pyrat/sv/sv-docs/dawinchi/CCP-wire-diag-1.png

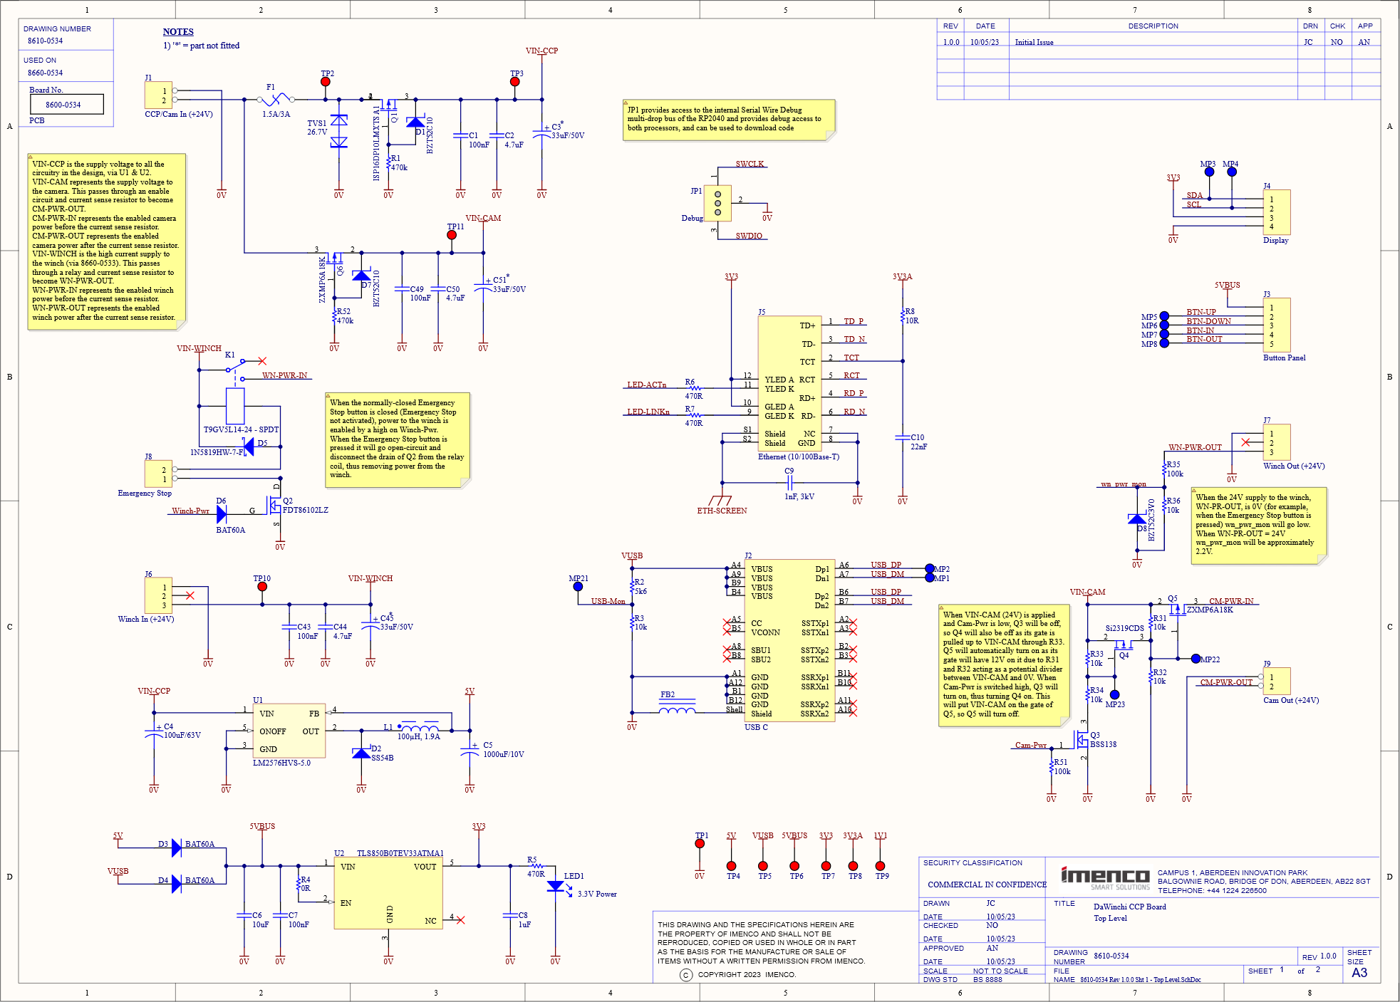
sv-docs/dawinchi/CCP-wire-diag-1.png
