pyrat/sv/sv-docs/dawinchi/CCP-wire-diag-2.png

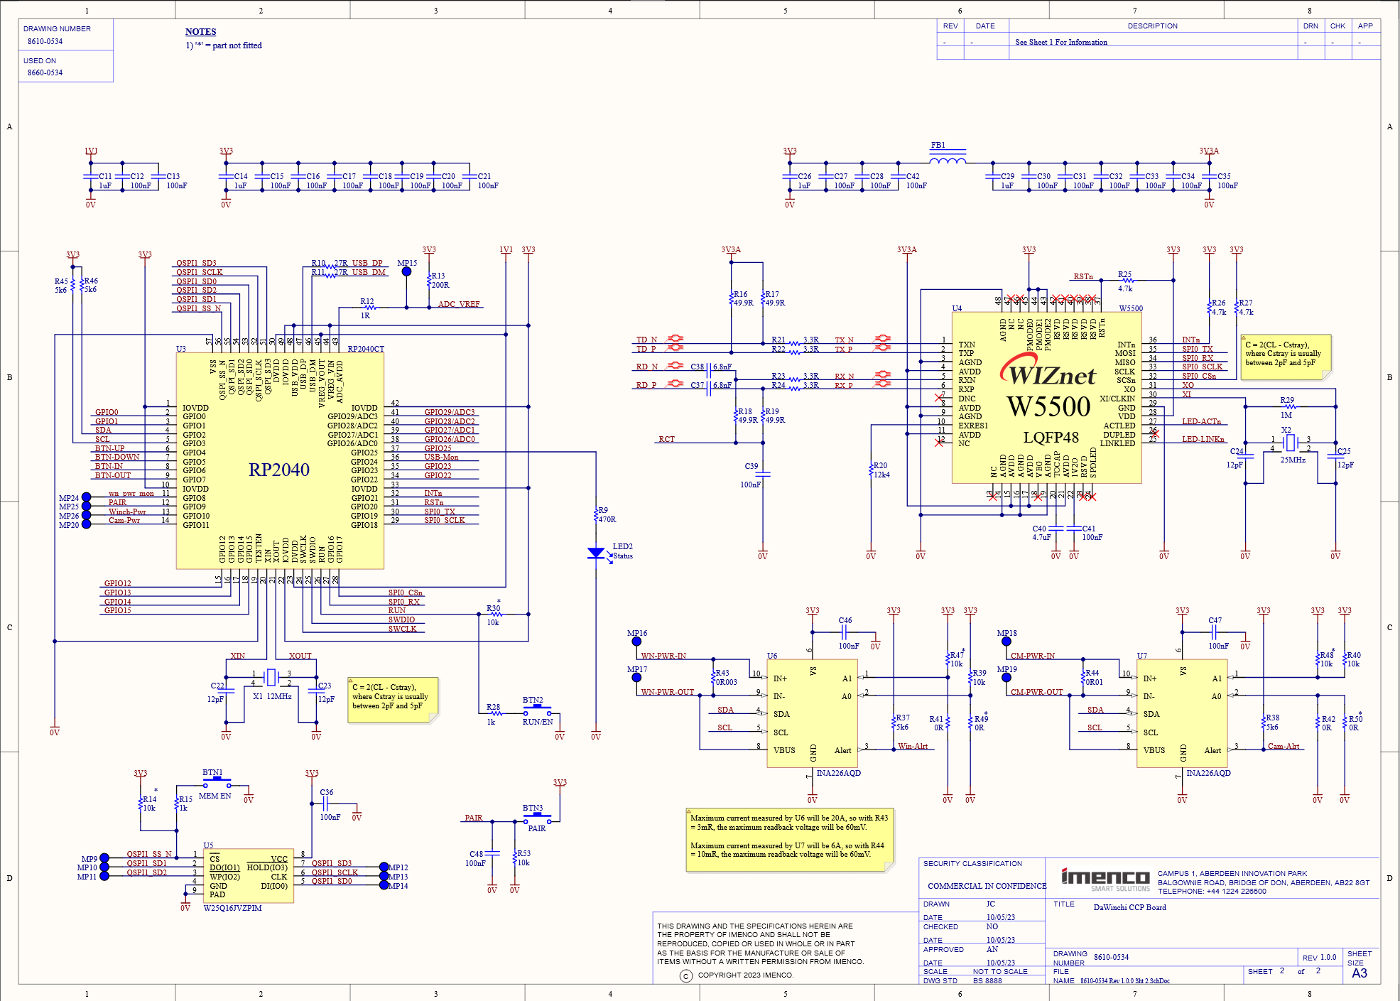
sv-docs/dawinchi/CCP-wire-diag-2.png
