pyrat/sv/sv-docs/dawinchi/dawinchi_ccp_oled_ui_design-hd.png

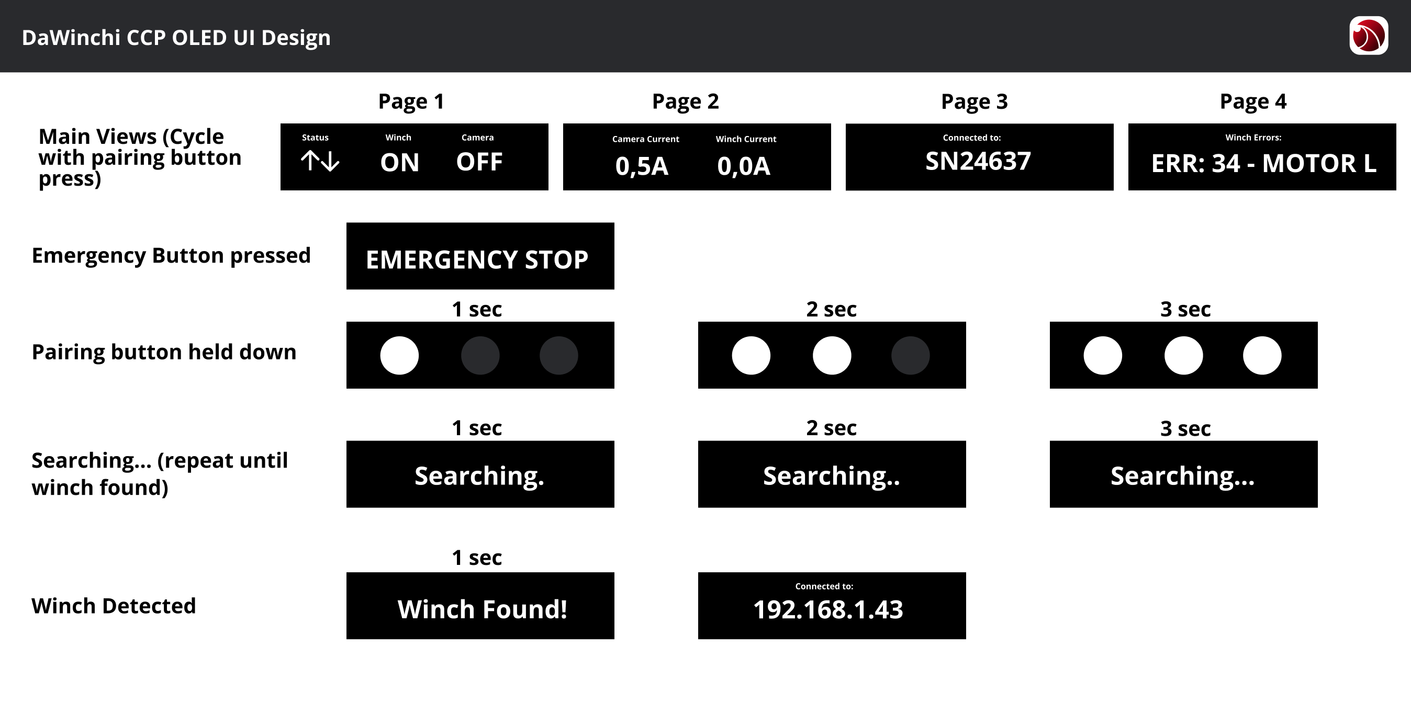
sv-docs/dawinchi/dawinchi_ccp_oled_ui_design-hd.png
