pyrat/sv/mechanical/prototype-enclosure/assembly-reference.stl

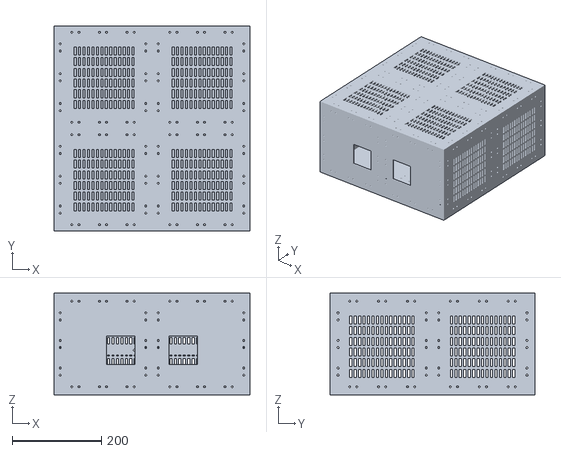
[picture p4: CAD file, 2026-10-30]
mechanical/prototype-enclosure/assembly-reference.stl
440.0 x 460.0 x 228.0
