pyrat/sv/mechanical/fit0737-din/fit0737-din-print-in-place.stl

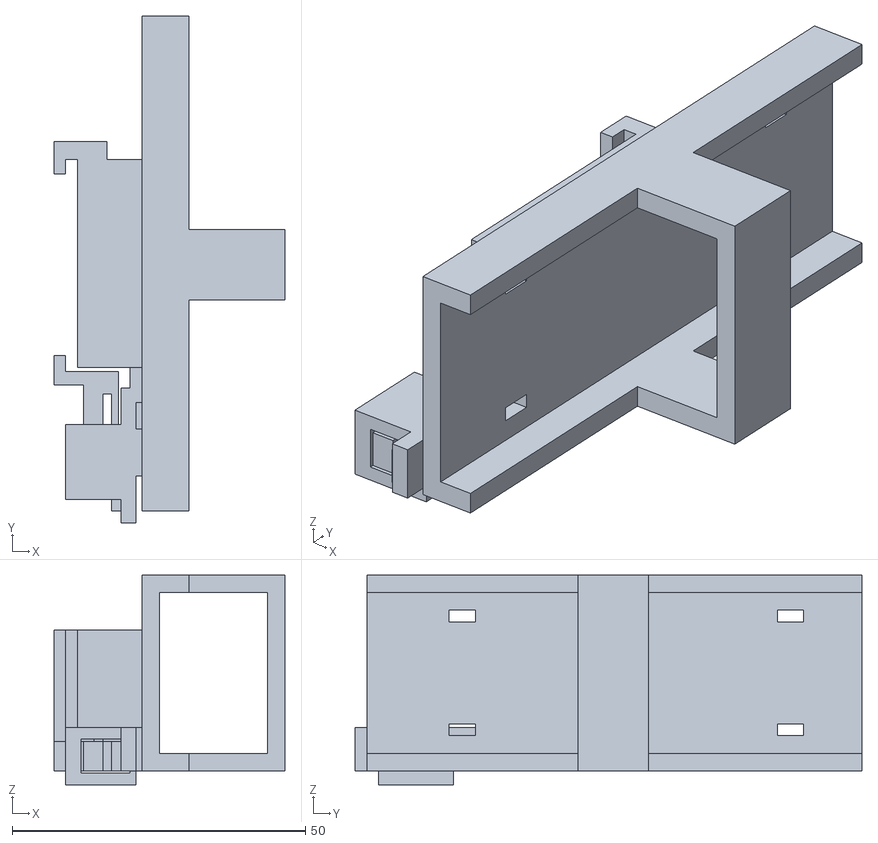
[picture p5: CAD file, 2026-11-07]
mechanical/fit0737-din/fit0737-din-print-in-place.stl
39.4 x 86.4 x 35.8
