pyrat/sv/mechanical/hinged-roof-v4/stl/shaft-blank.stl

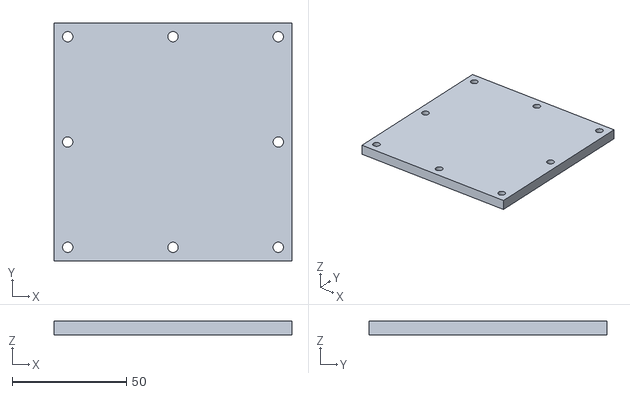
[picture p6: CAD file, 2026-10-30]
mechanical/hinged-roof-v4/stl/shaft-blank.stl
104.0 x 104.0 x 6.00
