pyrat/sv/mechanical/jetson-orin-din/jetson-orin-din-clip-test.stl

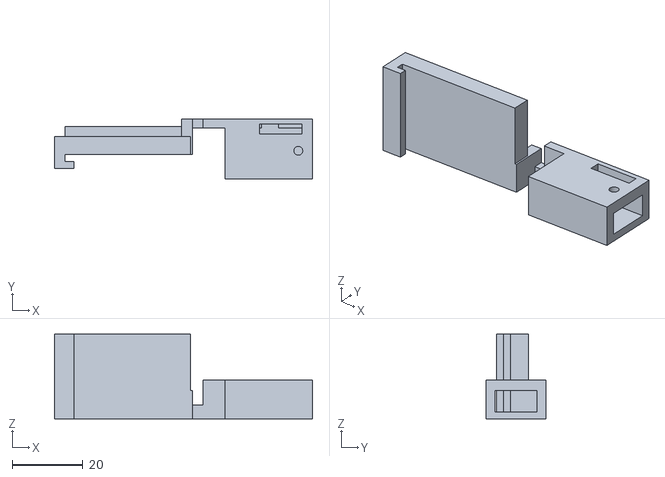
[picture p7: CAD file, 2026-11-07]
mechanical/jetson-orin-din/jetson-orin-din-clip-test.stl
73.0 x 17.0 x 24.0
