pyrat/sv/mechanical/outdoor-enclosure/stl/interface-gasket-tpu.stl

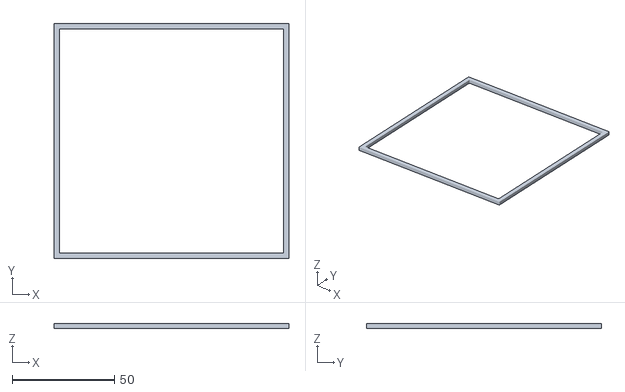
[picture p8: CAD file, 2026-10-30]
mechanical/outdoor-enclosure/stl/interface-gasket-tpu.stl
114.8 x 114.8 x 2.40
