pyrat/sv/mechanical/printed-drums/y-removable-flange.stl

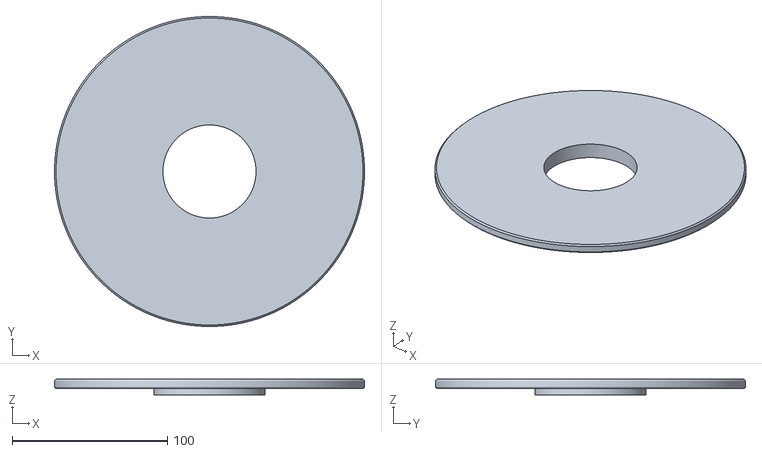
[picture p9: CAD file, 2026-10-15]
mechanical/printed-drums/y-removable-flange.stl
200.0 x 200.0 x 10.0
