pyrat/sv/mechanical/prototype-drums/drum-body.stl

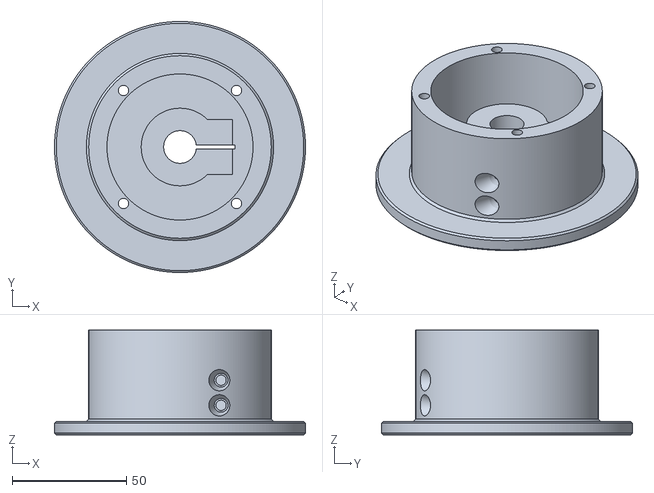
[picture p10: CAD file, 2026-10-28]
mechanical/prototype-drums/drum-body.stl
110.0 x 110.0 x 46.0
