pyrat/sv/mechanical/prototype-enclosure/stl/seam-splice.stl

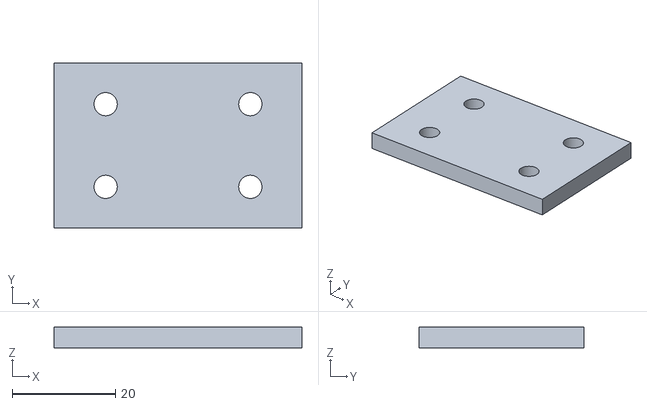
[picture p11: CAD file, 2026-10-30]
mechanical/prototype-enclosure/stl/seam-splice.stl
48.0 x 32.0 x 4.00
