pyrat/sv/mechanical/two-box-v3/stl/equipment-mounting-blank.stl

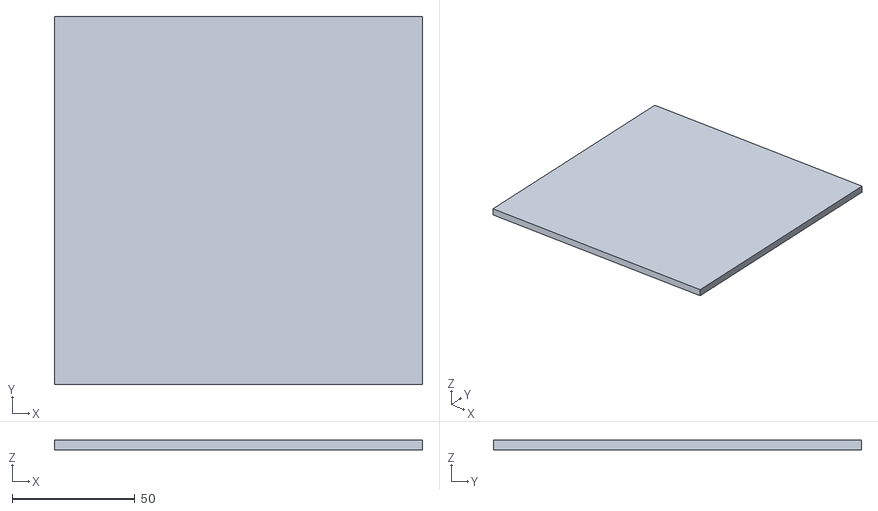
[picture p12: CAD file, 2026-10-30]
mechanical/two-box-v3/stl/equipment-mounting-blank.stl
150.0 x 150.0 x 4.00
