pyrat/sv/mechanical/hinged-roof-v4/stl/motor-base-fit-template.stl

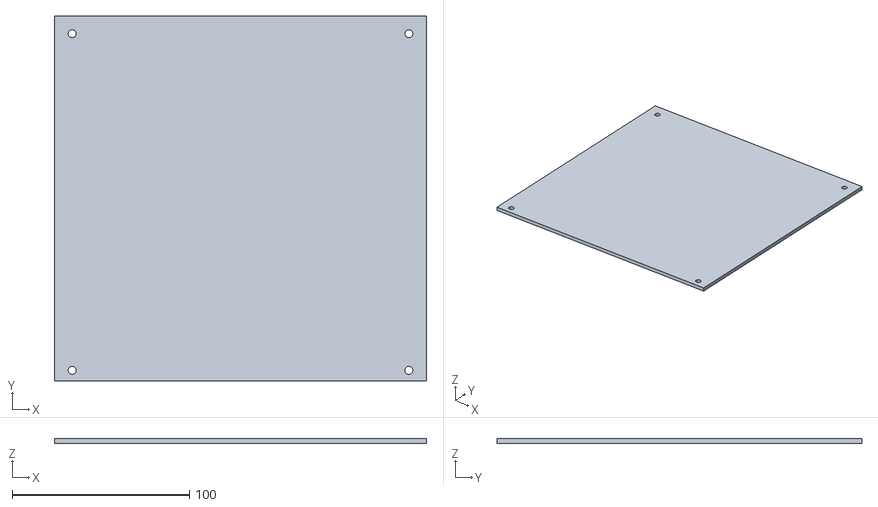
[picture p13: CAD file, 2026-10-30]
mechanical/hinged-roof-v4/stl/motor-base-fit-template.stl
210.0 x 206.0 x 3.00
