pyrat/sv/mechanical/jetson-orin-din/jetson-orin-din-slider.stl

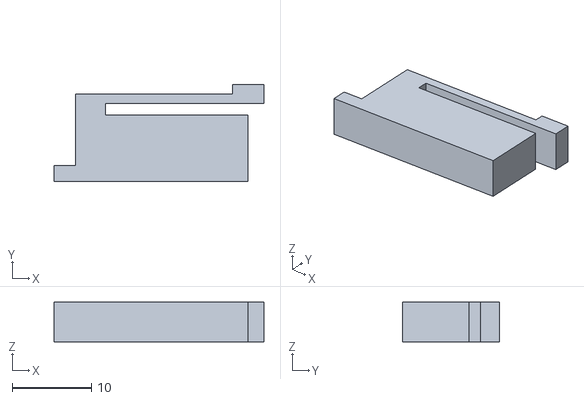
[picture p14: CAD file, 2026-11-07]
mechanical/jetson-orin-din/jetson-orin-din-slider.stl
26.5 x 12.2 x 5.00
