pyrat/sv/mechanical/outdoor-enclosure/stl/seal-test-base.stl

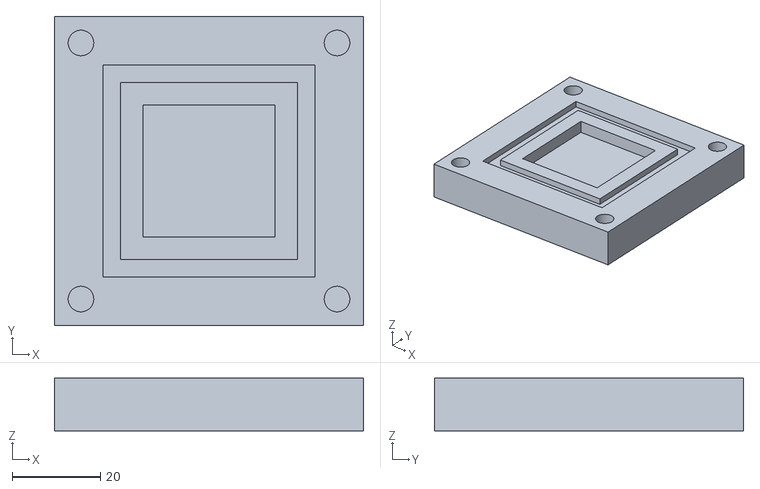
[picture p15: CAD file, 2026-10-30]
mechanical/outdoor-enclosure/stl/seal-test-base.stl
70.0 x 70.0 x 12.0
