pyrat/sv/mechanical/printed-drums/x-removable-flange.stl

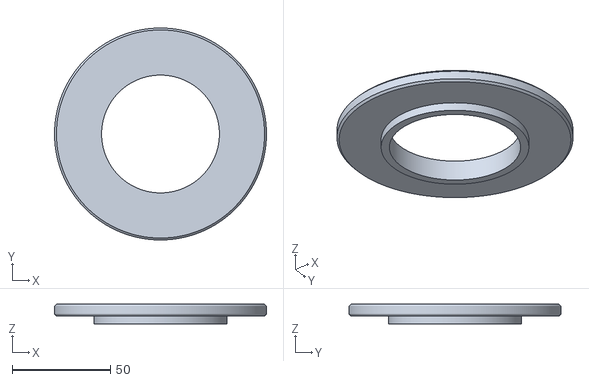
[picture p16: CAD file, 2026-10-15]
mechanical/printed-drums/x-removable-flange.stl
108.0 x 108.0 x 10.0
