pyrat/sv/mechanical/prototype-drums/drum-one-piece.stl

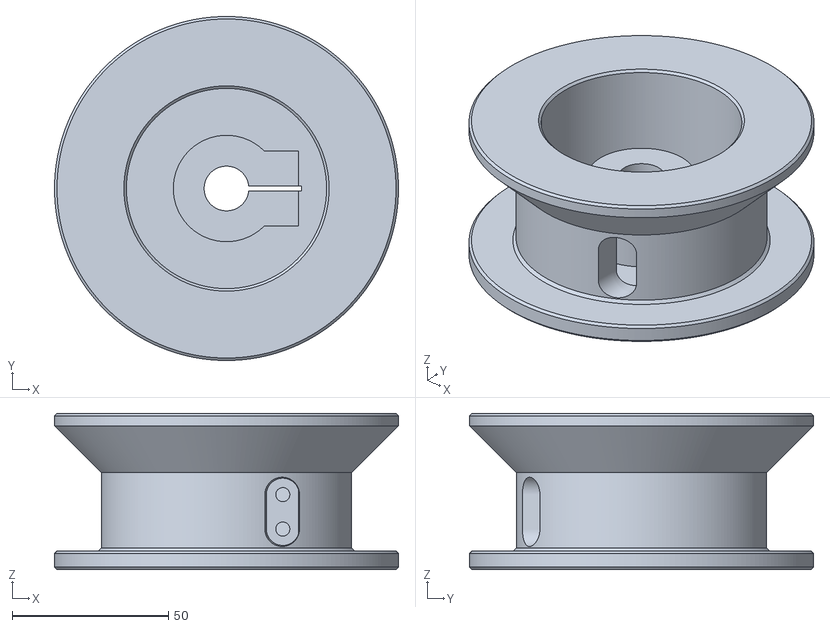
[picture p17: CAD file, 2026-10-28]
mechanical/prototype-drums/drum-one-piece.stl
110.0 x 110.0 x 50.0
