pyrat/sv/mechanical/prototype-enclosure/stl/rail-spacer.stl

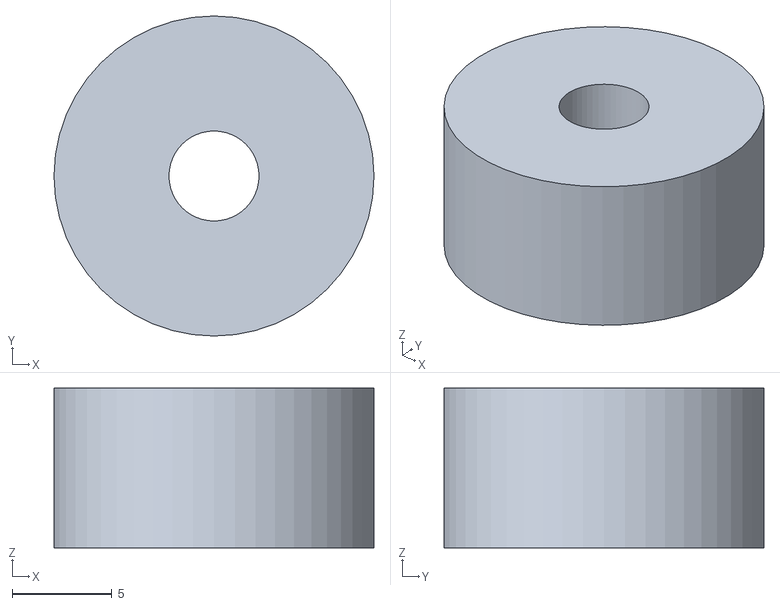
[picture p18: CAD file, 2026-10-30]
mechanical/prototype-enclosure/stl/rail-spacer.stl
16.0 x 16.0 x 8.00
