pyrat/sv/mechanical/two-box-v3/stl/winch-base.stl

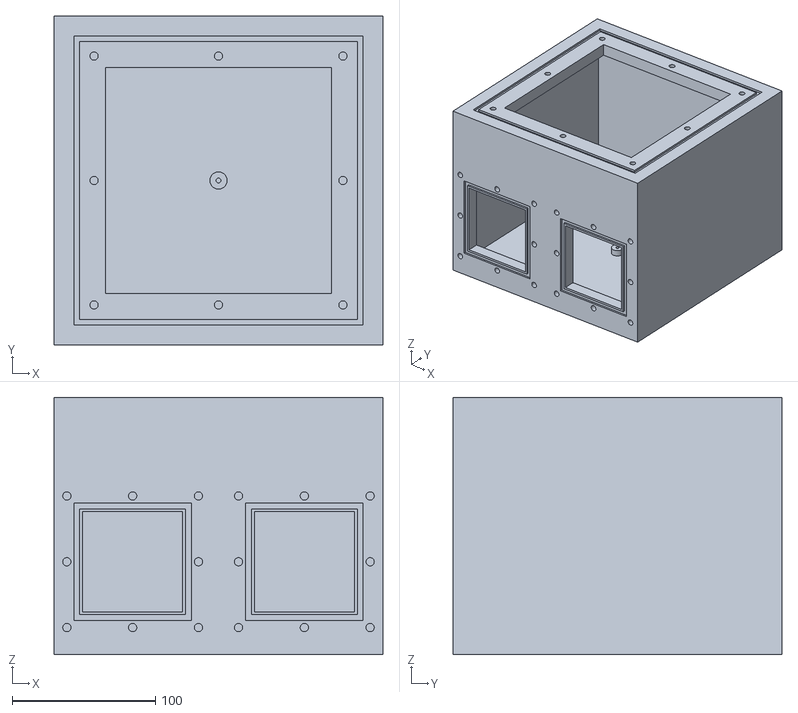
[picture p19: CAD file, 2026-10-30]
mechanical/two-box-v3/stl/winch-base.stl
230.0 x 230.0 x 180.0
