pyrat/sv/mechanical/hinged-roof-v4/stl/hinge-fixed-fit-template.stl

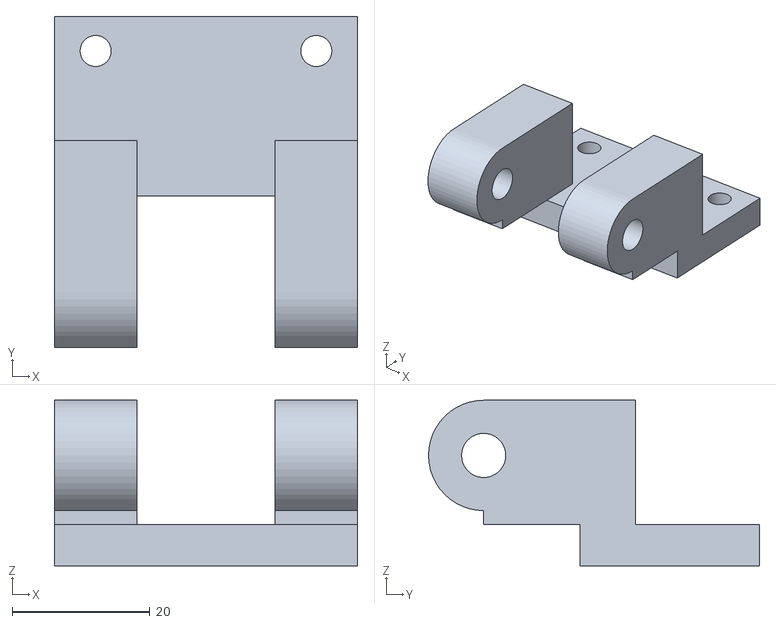
[picture p20: CAD file, 2026-10-30]
mechanical/hinged-roof-v4/stl/hinge-fixed-fit-template.stl
44.0 x 48.0 x 24.0
