pyrat/sv/mechanical/jetson-orin-din/jetson-orin-din-body.stl

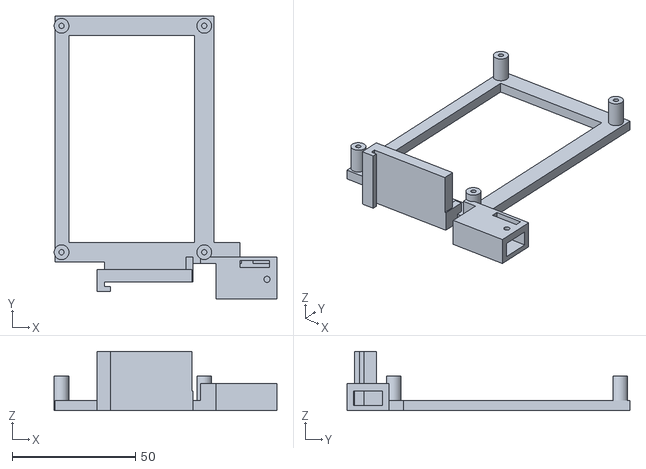
[picture p21: CAD file, 2026-11-07]
mechanical/jetson-orin-din/jetson-orin-din-body.stl
90.5 x 115.0 x 24.0
