pyrat/sv/mechanical/outdoor-enclosure/stl/cell-body.stl

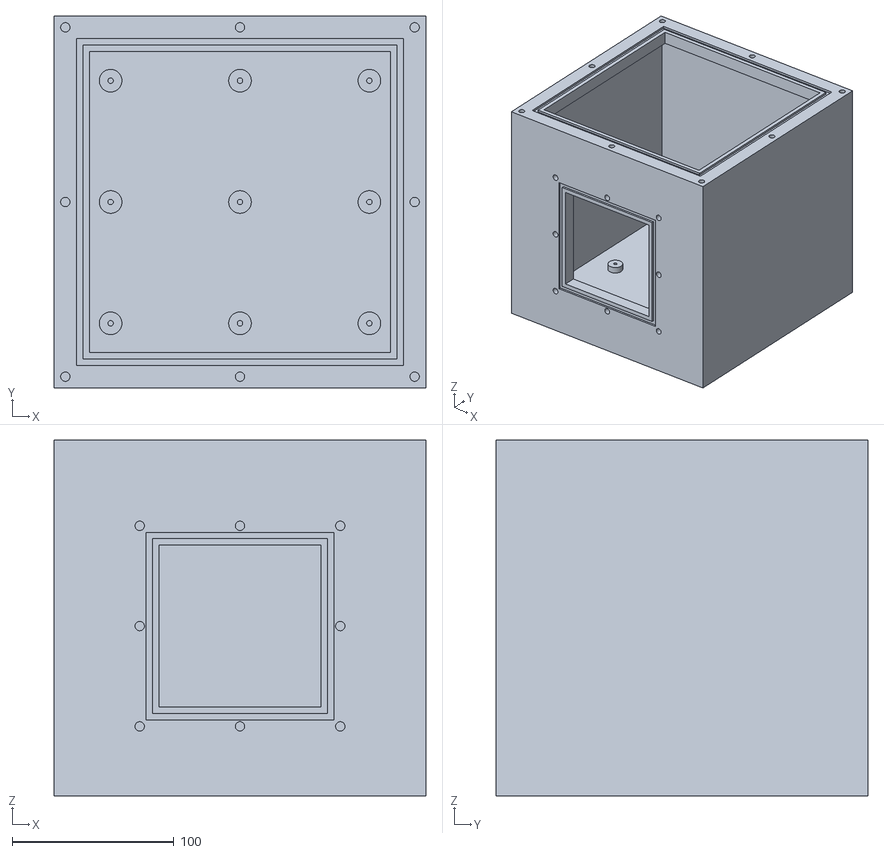
[picture p22: CAD file, 2026-10-30]
mechanical/outdoor-enclosure/stl/cell-body.stl
230.0 x 230.0 x 220.0
