pyrat/sv/mechanical/prototype-enclosure/stl/equipment-pad.stl

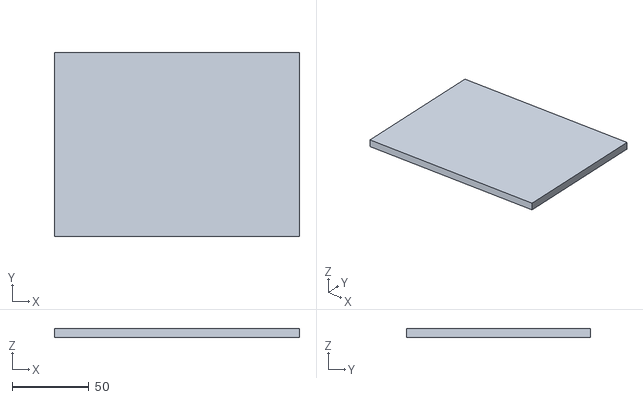
[picture p23: CAD file, 2026-10-30]
mechanical/prototype-enclosure/stl/equipment-pad.stl
160.0 x 120.0 x 6.00
