pyrat/sv/mechanical/two-box-v3/stl/winch-riser.stl

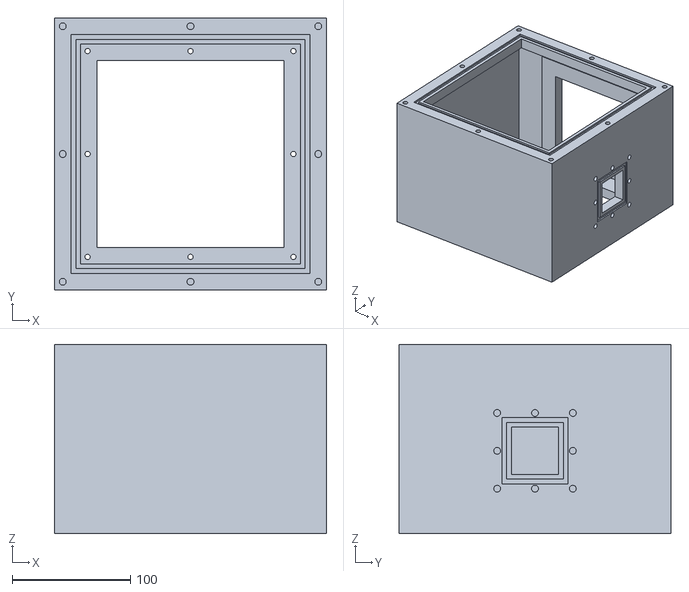
[picture p24: CAD file, 2026-10-30]
mechanical/two-box-v3/stl/winch-riser.stl
230.0 x 230.0 x 160.0
