pyrat/sv/mechanical/hinged-roof-v4/stl/driver-suspension-fit-template.stl

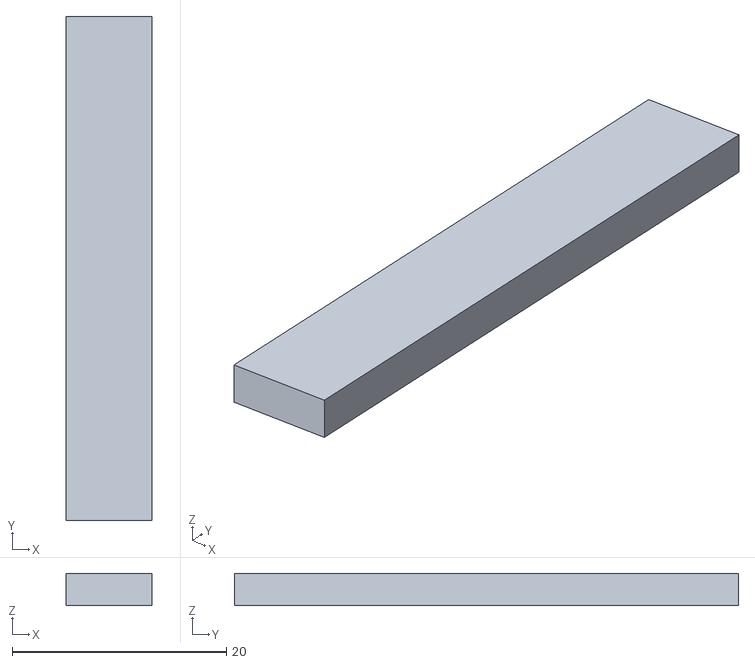
[picture p25: CAD file, 2026-10-30]
mechanical/hinged-roof-v4/stl/driver-suspension-fit-template.stl
8.00 x 47.0 x 3.00
