pyrat/sv/mechanical/jetson-orin-din/jetson-orin-din-print-in-place.stl

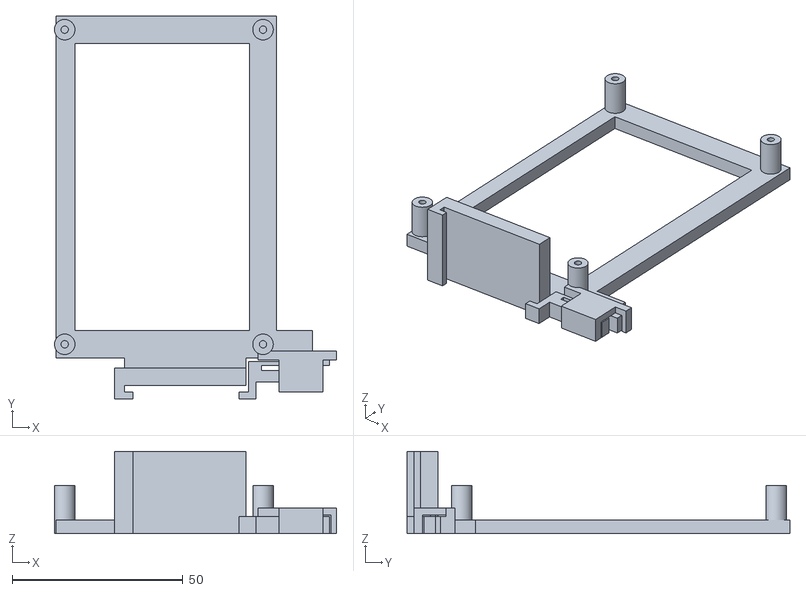
[picture p26: CAD file, 2026-11-04]
mechanical/jetson-orin-din/jetson-orin-din-print-in-place.stl
82.5 x 112.0 x 24.0
