pyrat/sv/mechanical/prototype-enclosure/stl/side-fan-tile.stl

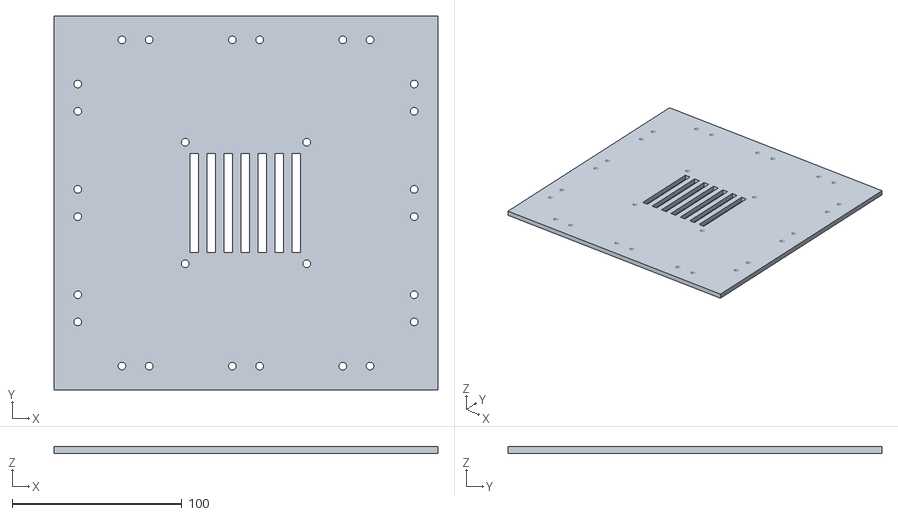
[picture p27: CAD file, 2026-10-30]
mechanical/prototype-enclosure/stl/side-fan-tile.stl
226.0 x 220.0 x 4.00
