pyrat/sv/mechanical/two-box-v3/stl/power-compute-riser.stl

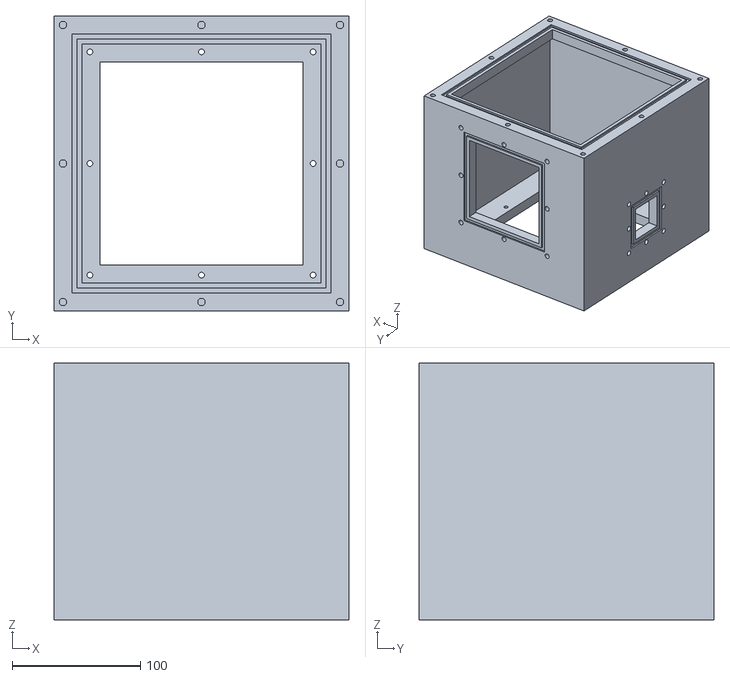
[picture p28: CAD file, 2026-10-30]
mechanical/two-box-v3/stl/power-compute-riser.stl
230.0 x 230.0 x 200.0
