pyrat/sv/mechanical/hinged-roof-v4/stl/din-suspension-fit-template.stl

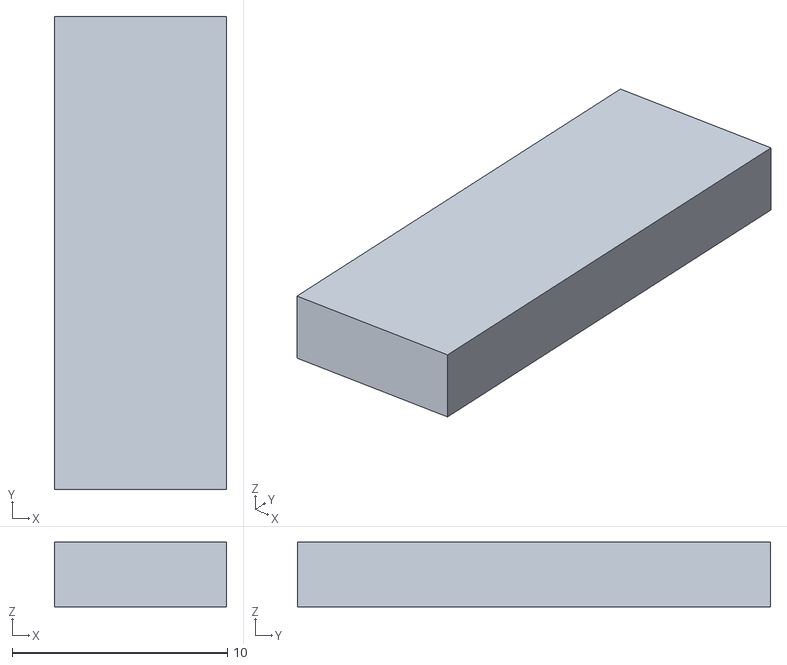
[picture p29: CAD file, 2026-10-30]
mechanical/hinged-roof-v4/stl/din-suspension-fit-template.stl
8.00 x 22.0 x 3.00
