pyrat/sv/mechanical/two-box-v3/stl/rain-skirt-lid.stl

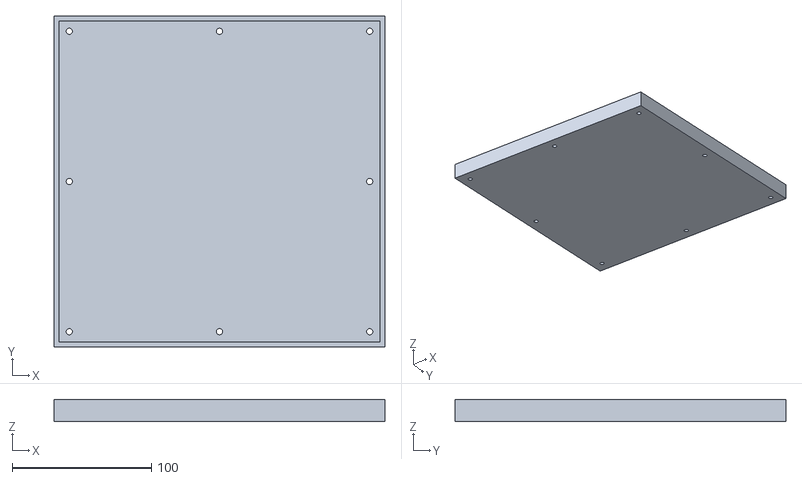
[picture p30: CAD file, 2026-10-30]
mechanical/two-box-v3/stl/rain-skirt-lid.stl
238.0 x 238.0 x 16.0
