pyrat/sv/mechanical/hinged-roof-v4/stl/hinged-hood.stl

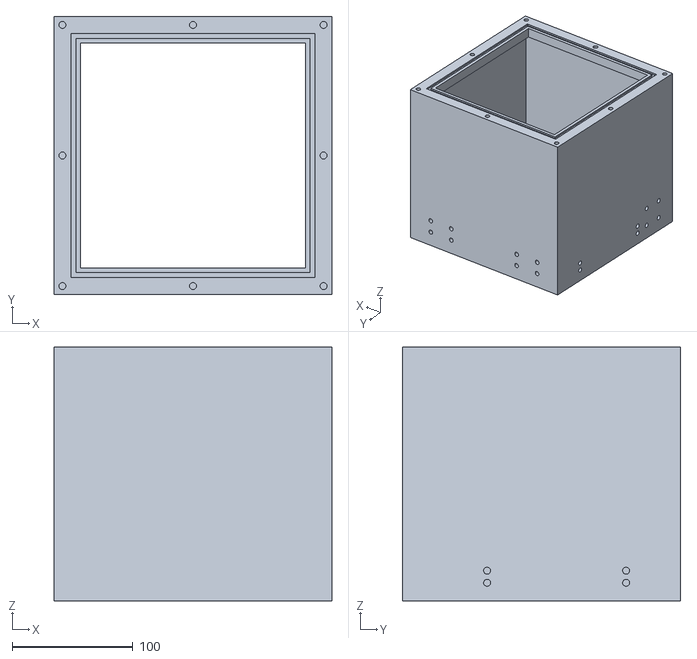
[picture p31: CAD file, 2026-10-30]
mechanical/hinged-roof-v4/stl/hinged-hood.stl
230.0 x 230.0 x 210.0
