pyrat/sv/mechanical/hinged-roof-v4/stl/closing-clamp-base-fit-template.stl

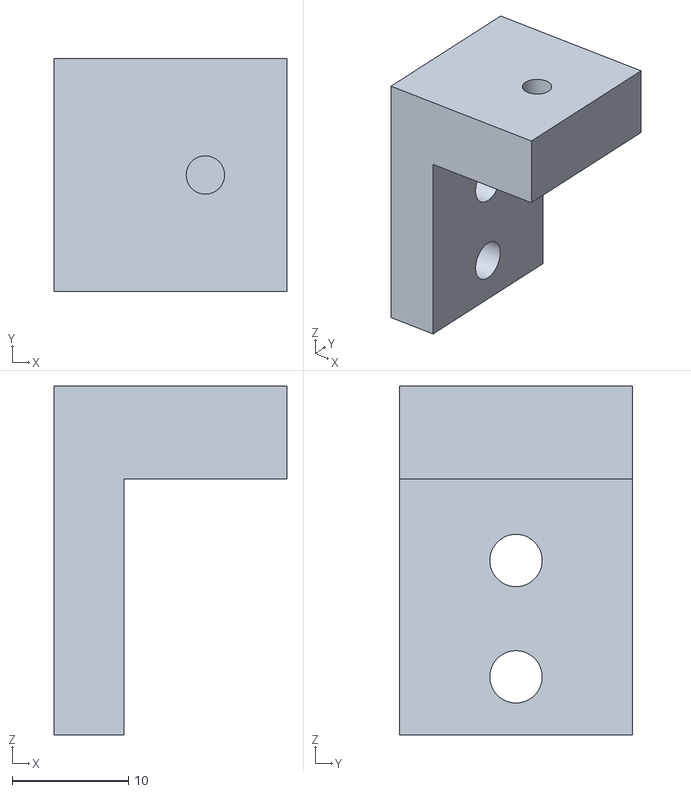
[picture p32: CAD file, 2026-10-30]
mechanical/hinged-roof-v4/stl/closing-clamp-base-fit-template.stl
20.0 x 20.0 x 30.0
