pyrat/sv/mechanical/hinged-roof-v4/stl/din-panel-fit-template.stl

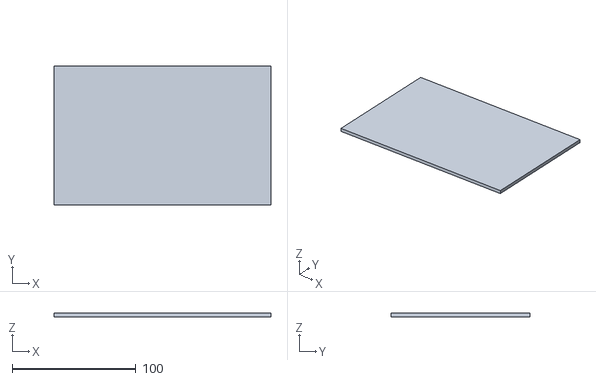
[picture p33: CAD file, 2026-10-30]
mechanical/hinged-roof-v4/stl/din-panel-fit-template.stl
175.0 x 112.0 x 3.00
