pyrat/sv/(list of files, cad)

Other CAD files:
mechanical/hinged-roof-v4/stl/roof.stl
