pyrat/sv/mechanical/ropesetup.png

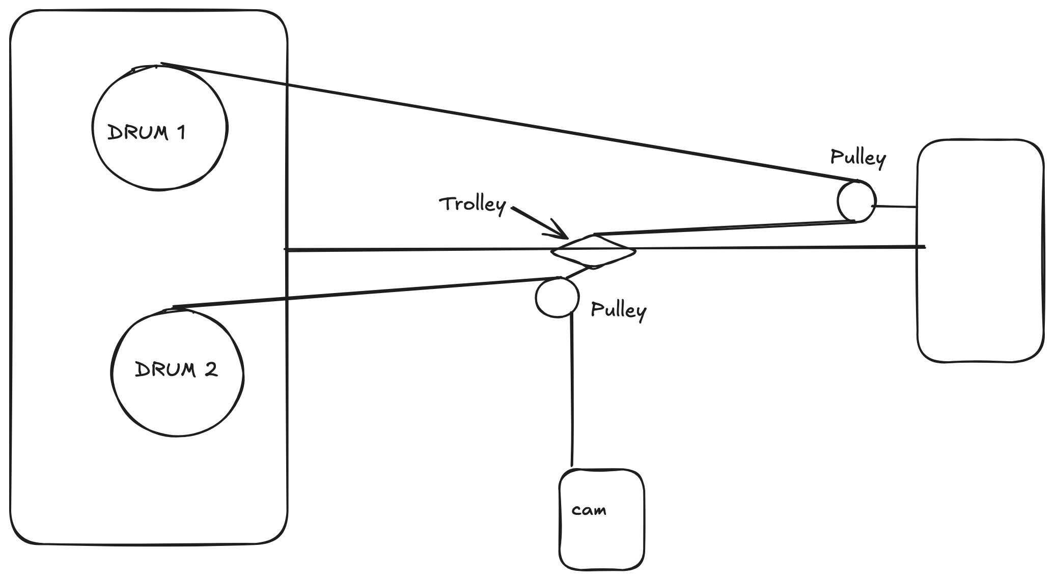
mechanical/ropesetup.png
