pyrat/sv/sv-docs/dawinchi/8610-0533_rev_1.0.0_shts_1_-_5_of_5.pdf

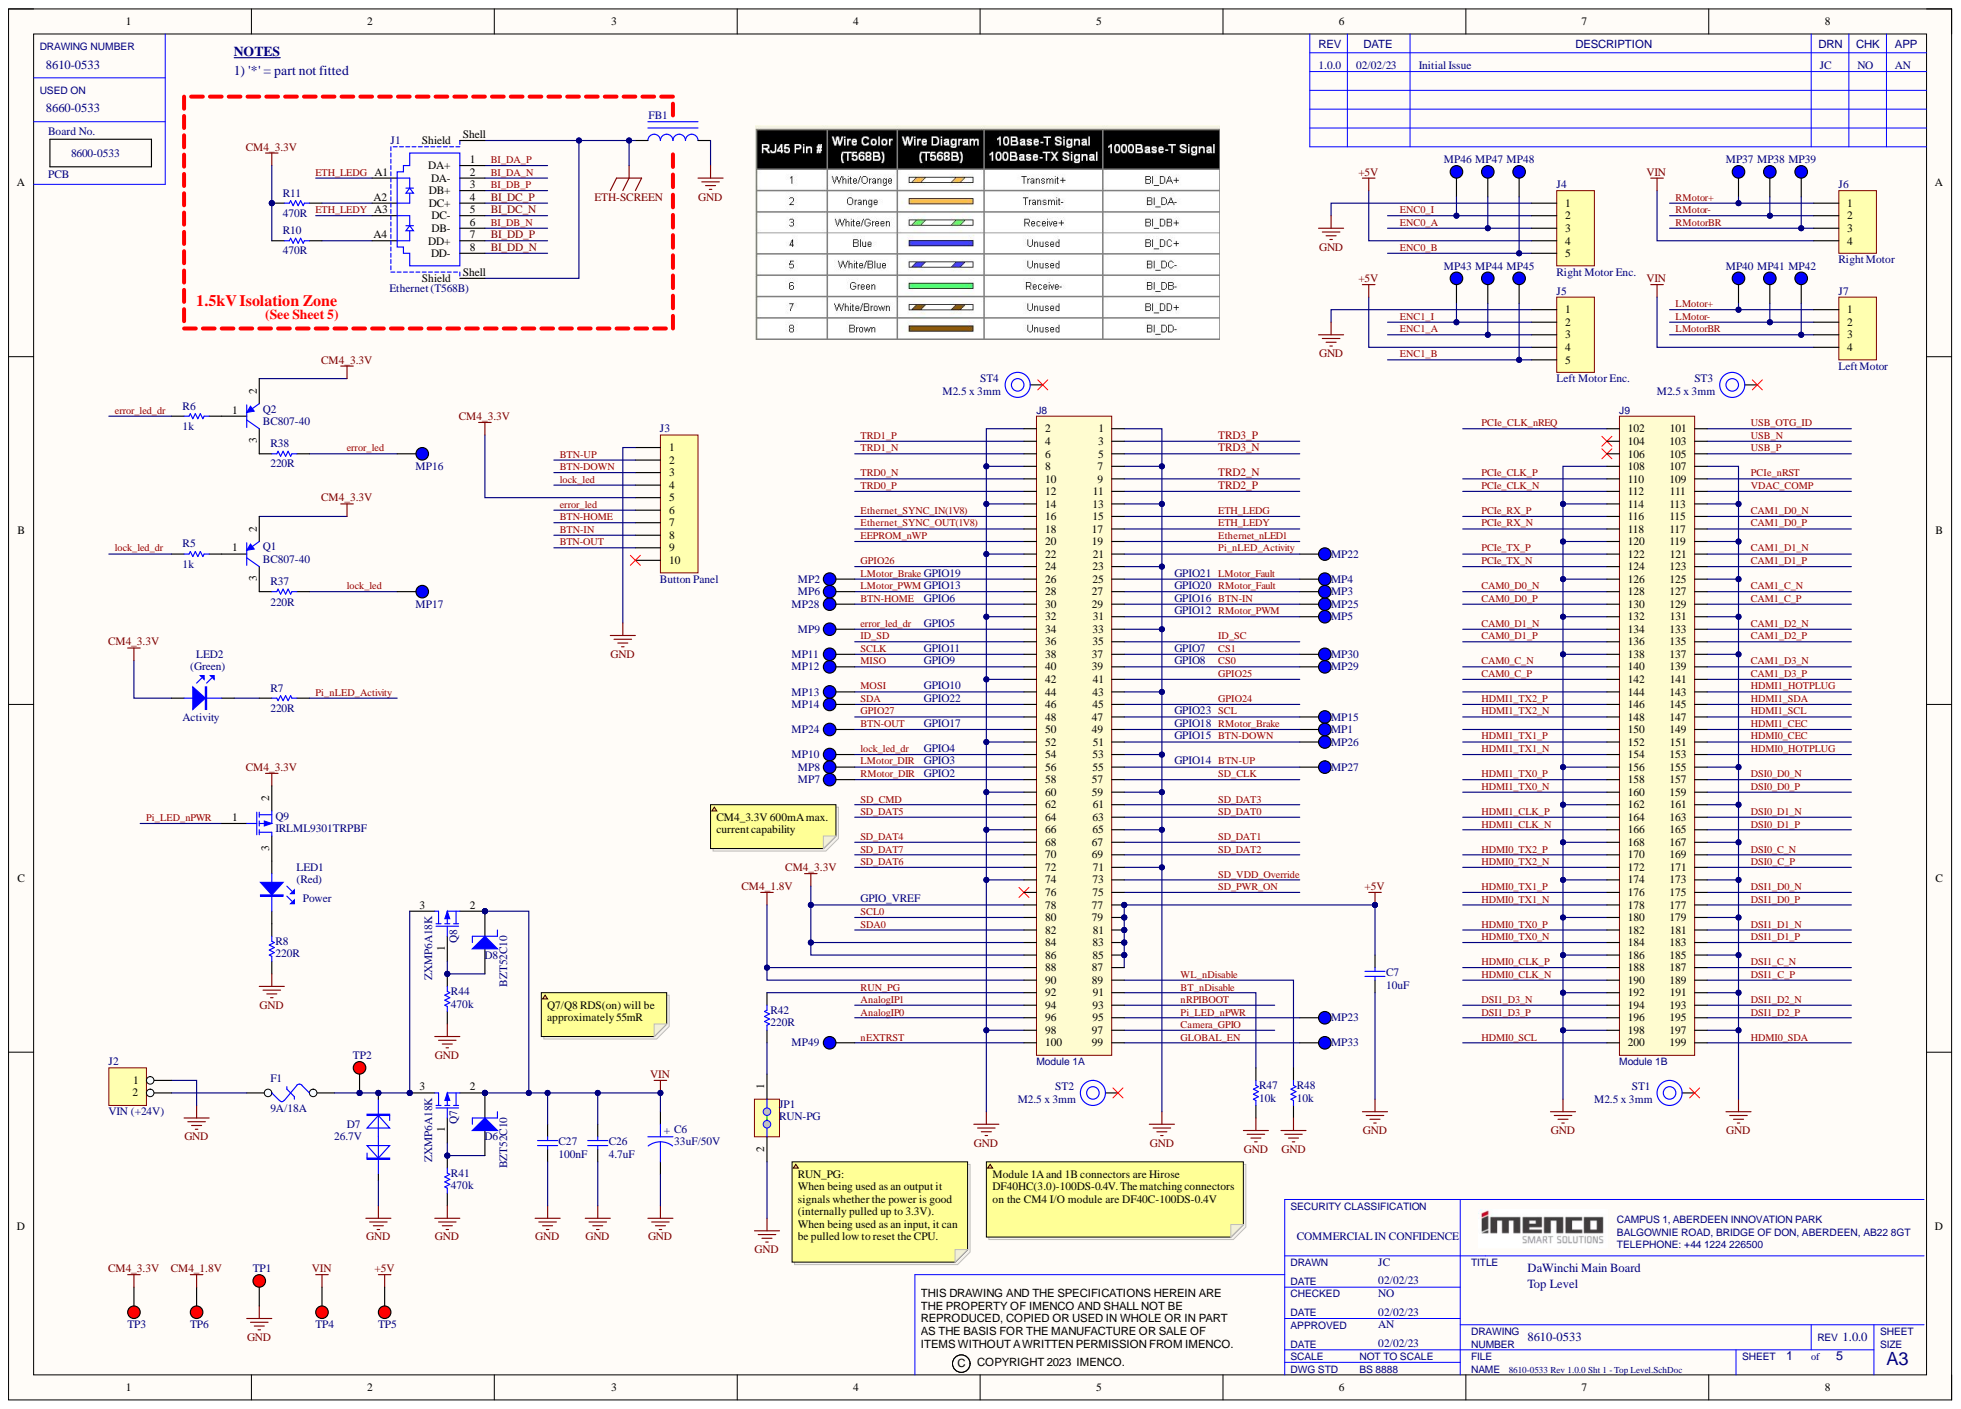
[picture p35: page 1]

N 1) '*' = part not fitted NOTES

When being used as an output
When being used as an

CAMPUS 1, ABERDEEN INNOV
BALGOWNIE ROAD, BRIDGE OF DON, ABERDEEN, AB22 8GT

NOT TO SCALE JC

8610-0533 Rev 1.0.0 Sht 1 - Top Level.SchDoc

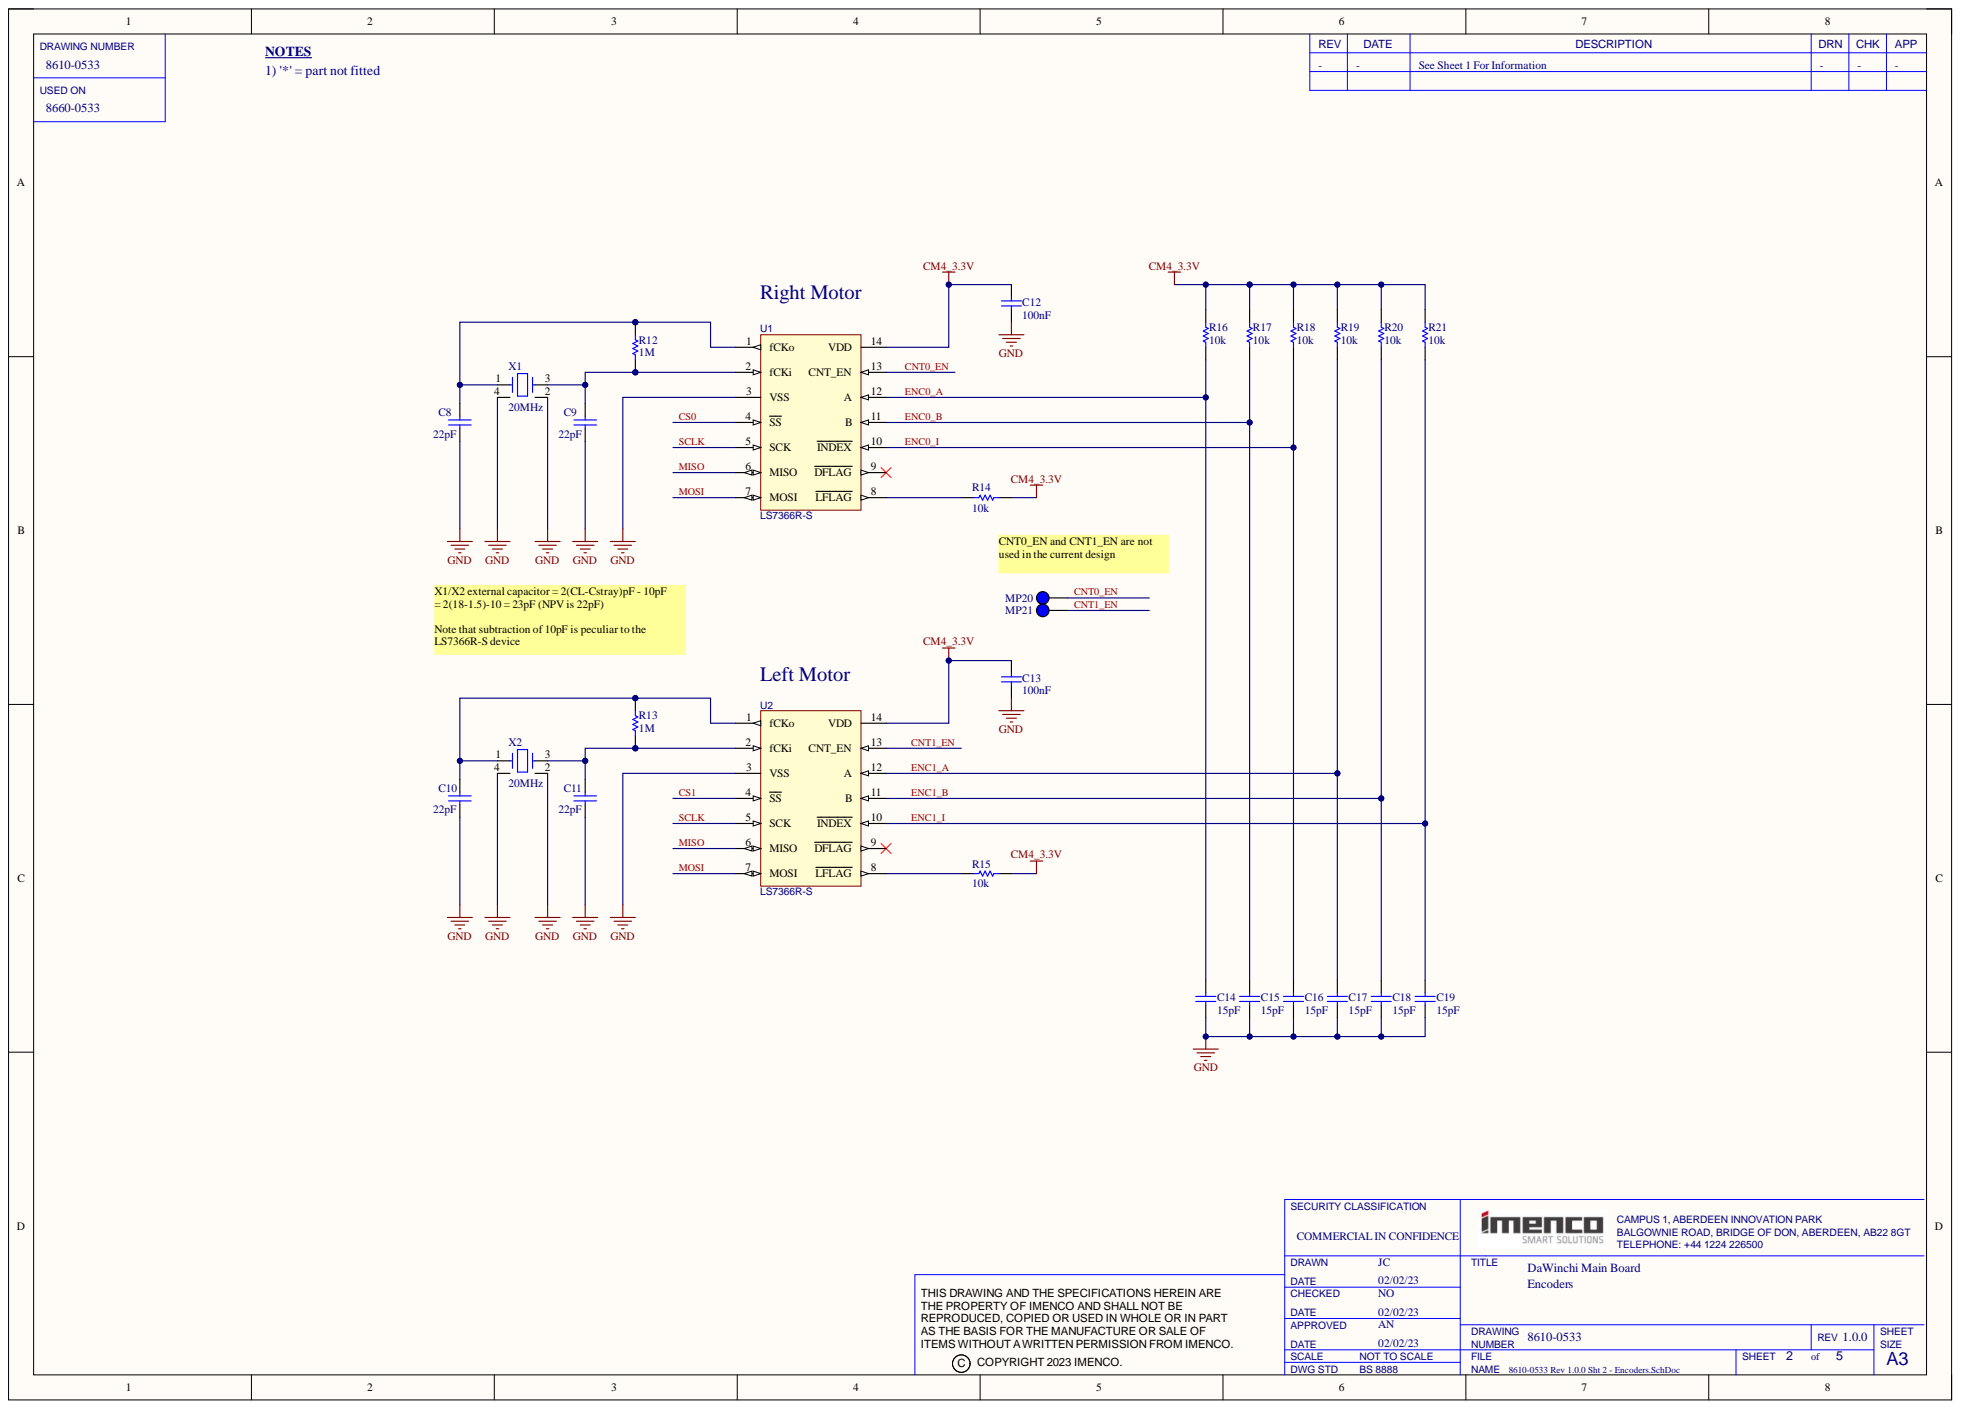
[picture p36: page 2]

CNT0_EN and CNT1_EN are not
used in the current design

X1/X2 external capacitor = 2(CL-Cstray)pF - 10pF
= 2(18-1.5)-10 = 23pF (NPV is 22pF)

Note that subtraction of 10pF is peculiar to the
LS7366R-S device

CAMPUS 1, ABERDEEN INNOVATION PARK
BALGOWNIE ROAD, BRIDGE OF DON, ABERDEEN, AB22 8GT
TELEPHONE: +44 1224 226500

THIS DRAWING AND THE SPECIFICATIONS HEREIN ARE
THE PROPERTY OF IMENCO AND SHALL NOT BE
REPRODUCED, COPIED OR USED IN WHOLE OR IN PART
AS THE BASIS FOR THE MANUFACTURE OR SALE OF
ITEMS WITHOUT AWRITTEN PERMISSION FROM IMENCO.

8610-0533 Rev 1.0.0 Sht 2 - Encoders.SchDoc

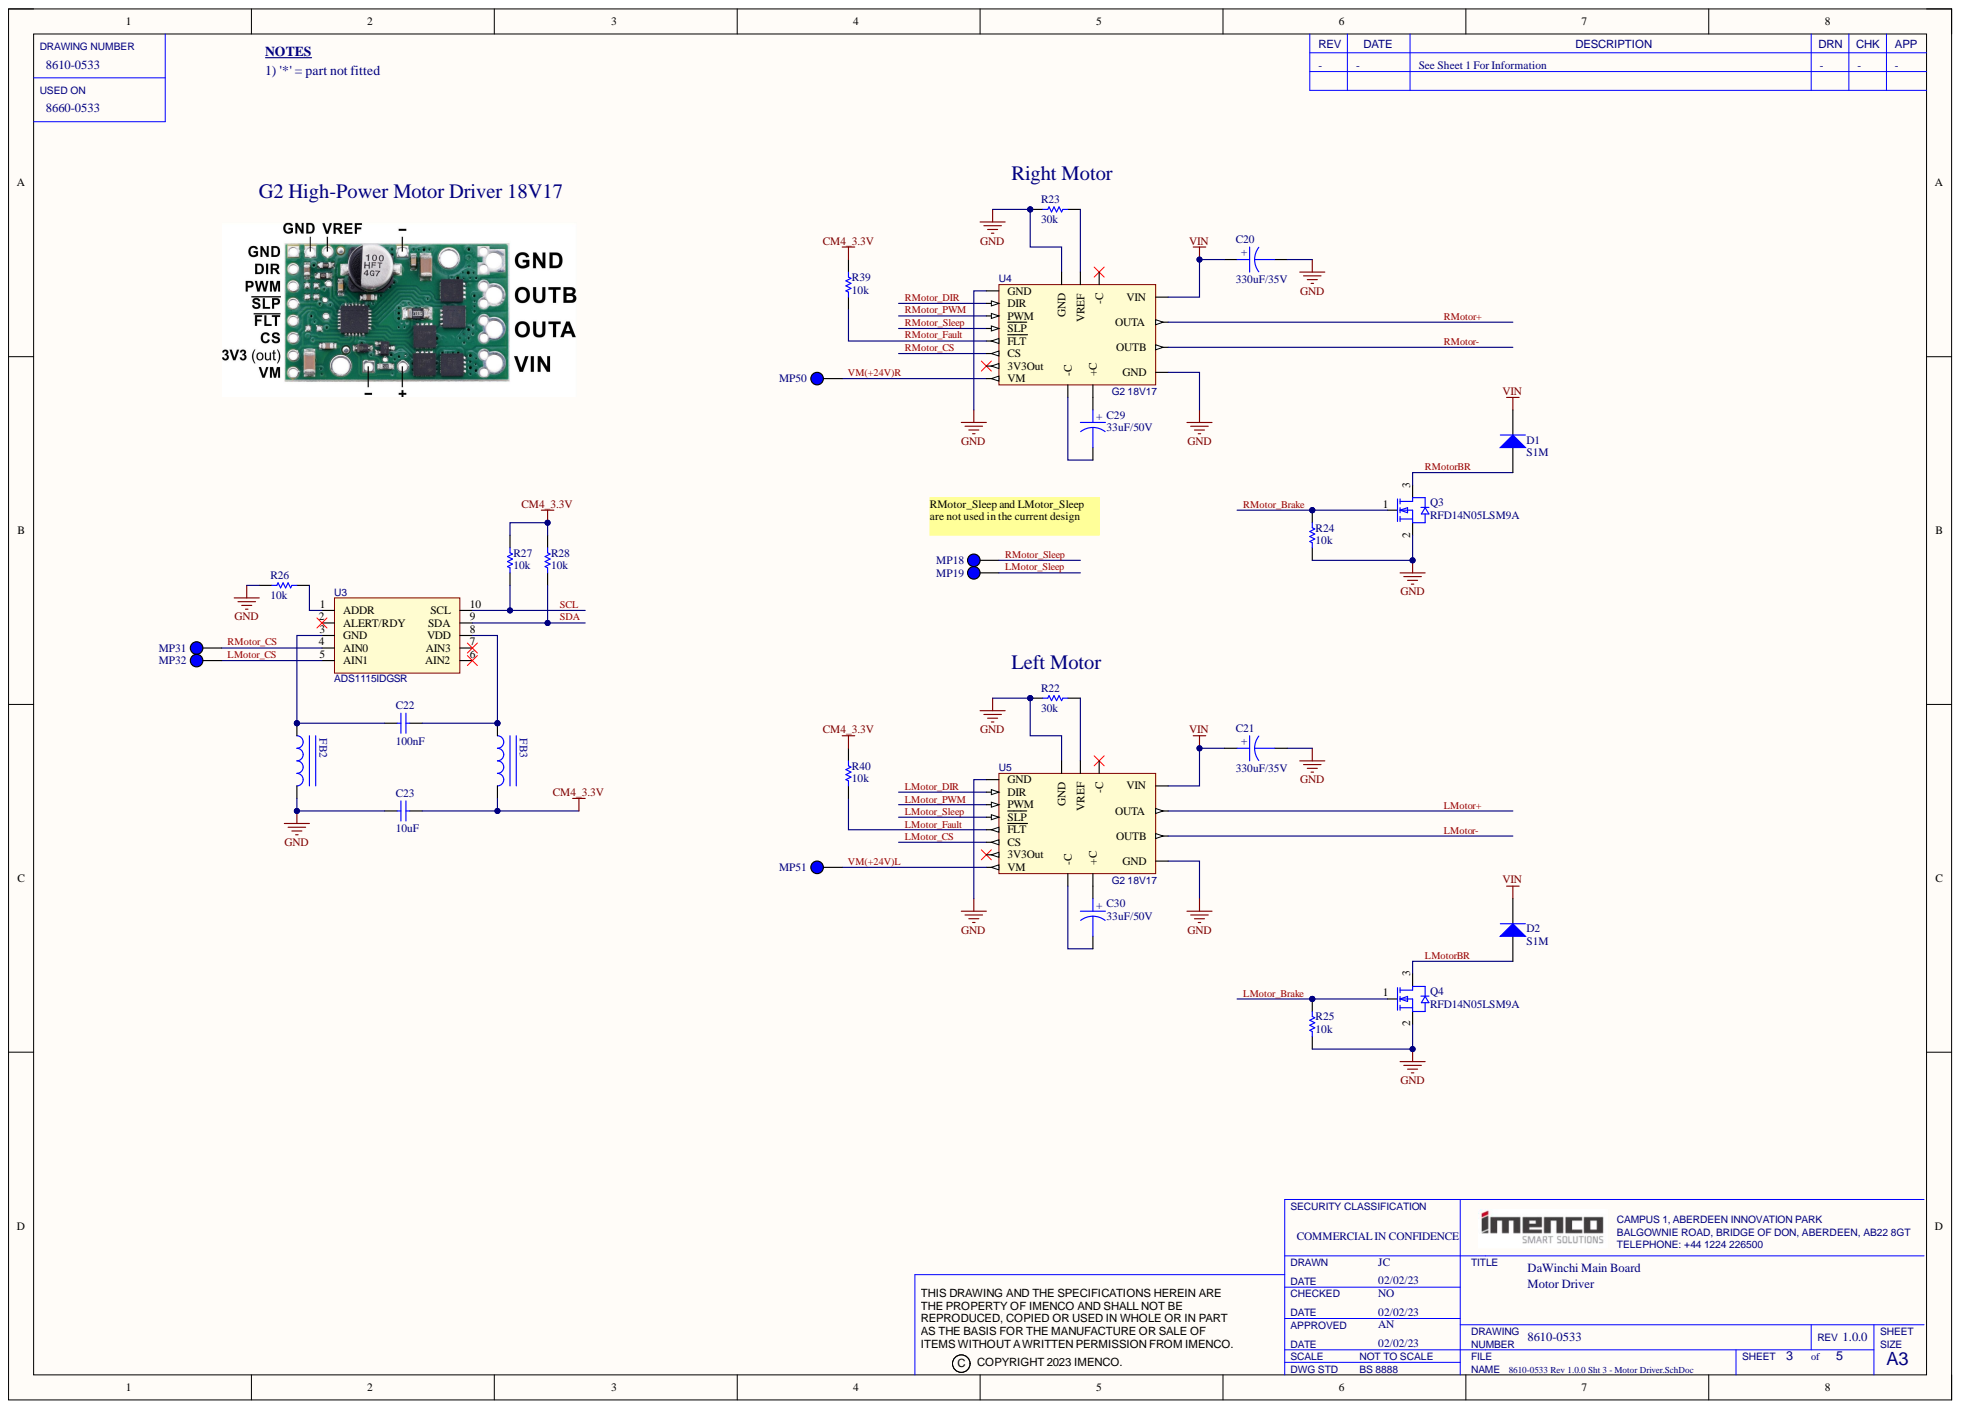
[picture p37: page 3]

G2 High-Power Motor Driver 18V17

CAMPUS 1, ABERDEEN INNOV
BALGOWNIE ROAD, BRIDGE OF DON, ABERDEEN, AB22 8GT
TELEPHONE:

NOT TO SCALE JC

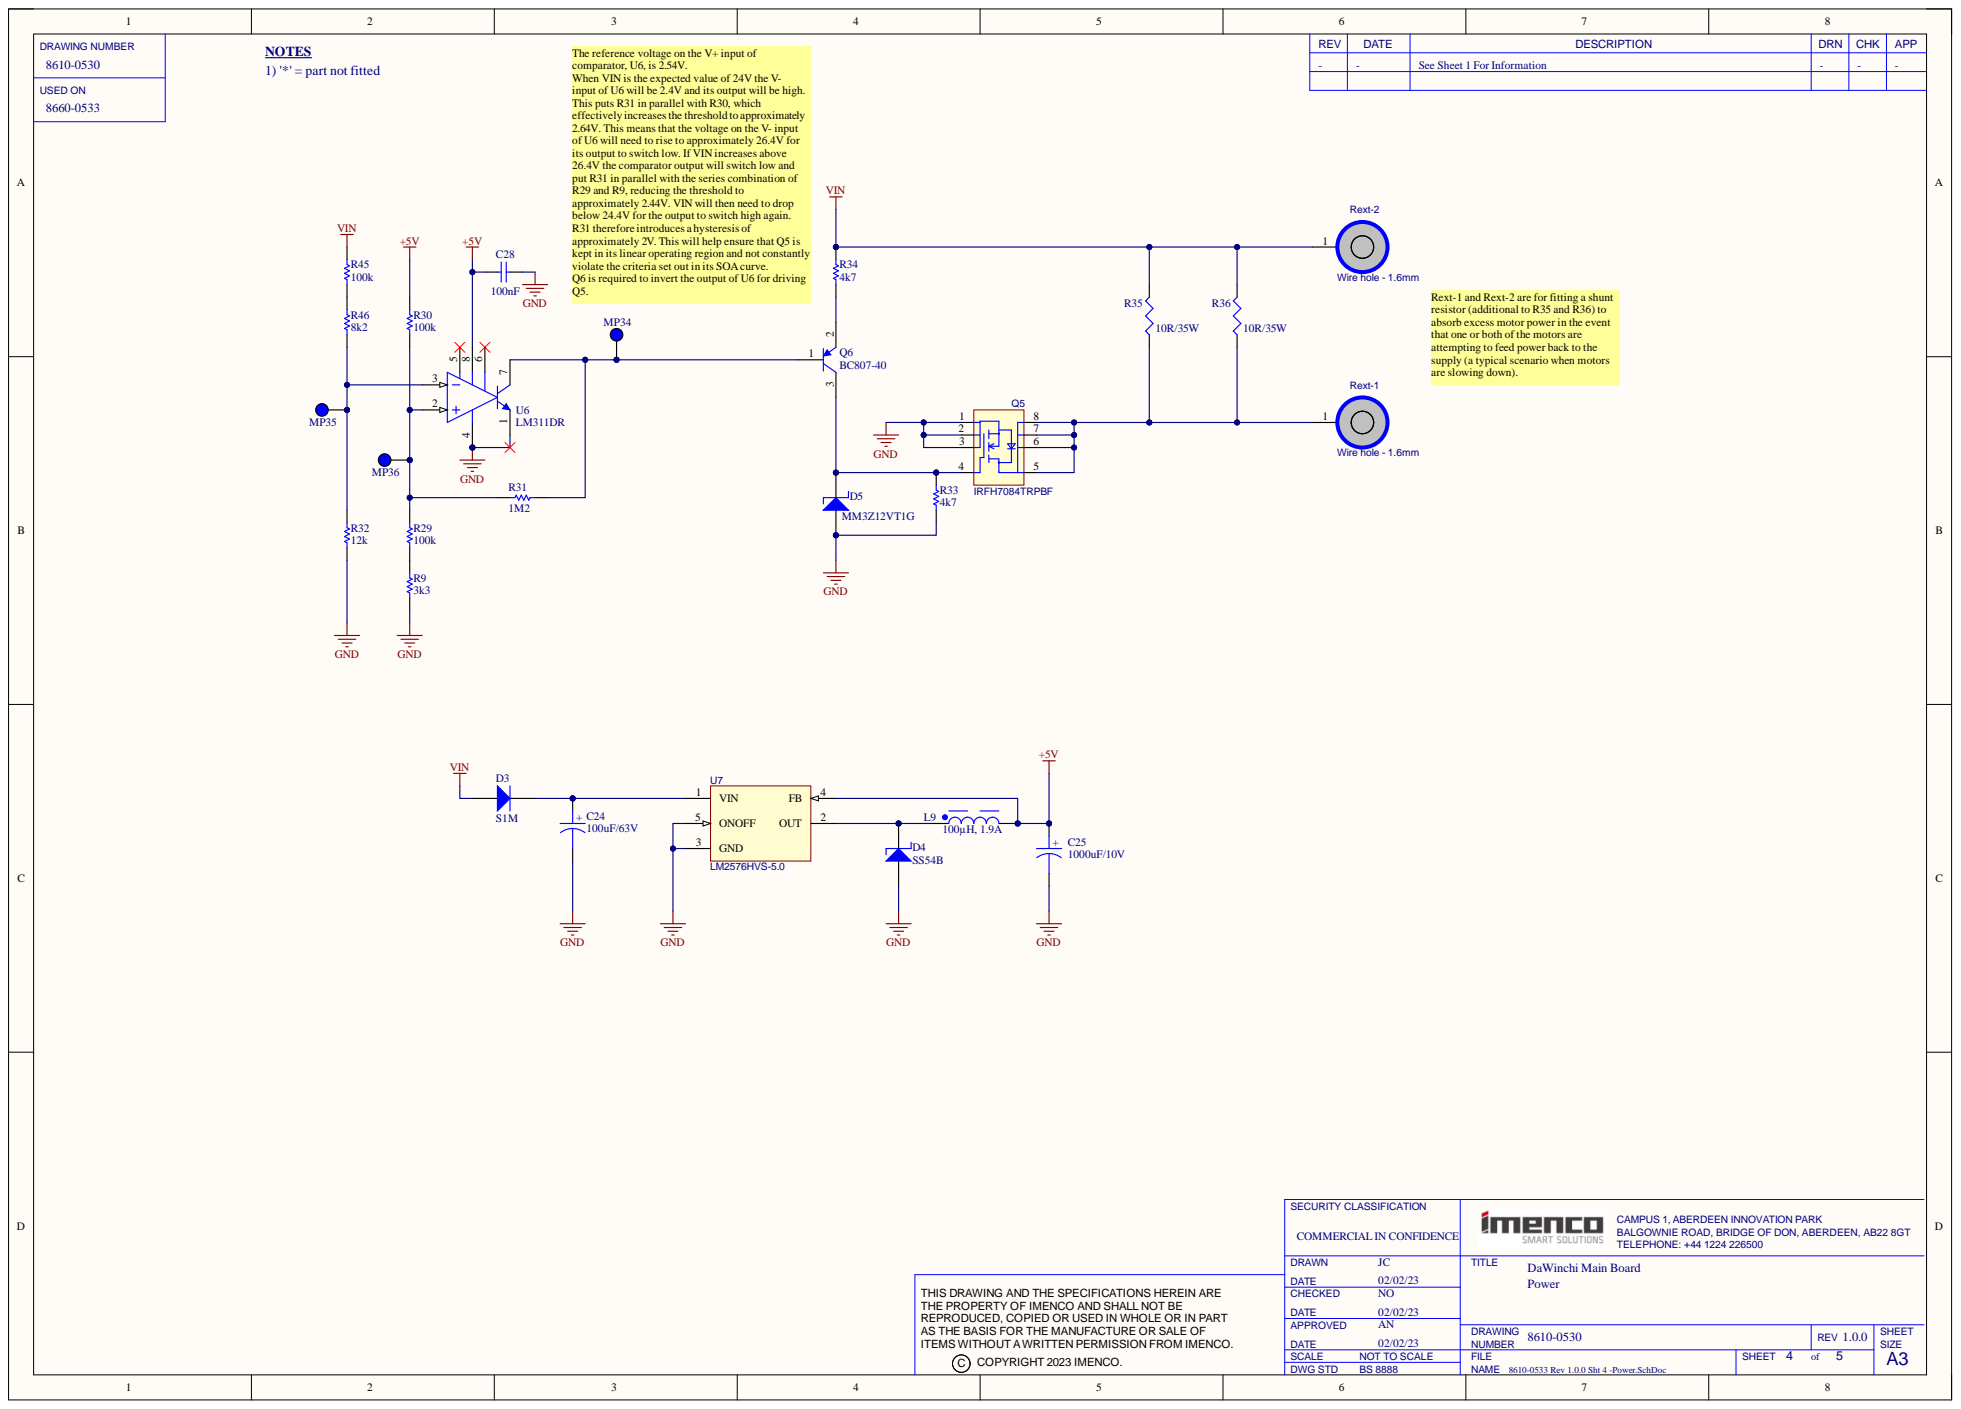
[picture p38: page 4]

comparator, U6, is 2.54V.
When VIN is the expected value of 24V the V- input of U6 will be 2.4V and its output will be high.

This puts R31 in parallel with R30, which
effectively increasesthe threshold to approximately
2.64V. This means that the voltage on the V- input
of U6 will need to rise to approximately 26.4V for
its output to switch low. If VIN increases above
26.4V the comparator output will switch low and
put R31 in parallel with the series combination of
R29 and R9, reducing the threshold to
approximately 2.44V. VIN will then need to drop
below 24.4V for the output to switch high again.
R31 therefore introduces a hysteresis of
approximately 2V. This will help ensure that Q5 is
kept in its linear operating region and not constantly
violate the criteria set out in its SOAcurve.
Q6 is required to invert the output of U6 for driving

Rext-1 and Rext-2 are for fitting a shunt
resistor (additional to R35 and R36) to
absorb excess motor power in the event
that one or both of the motors are
attempting to feed power back to the
supply (a typical scenario when motors

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

THIS DRAWING AND THE SPECIFICATIONS HEREIN ARE THE PROPERTY OF IMENCO AND SHALL NOT BE REPRODUCED, COPIED OR USED IN WHOLE OR IN PART AS THE BASIS FOR THE MANUFACTURE OR SALE OF ITEMS WITHOUT AWRITTEN PERMISSION FROM IMENCO. C COPYRIGHT 2023 IMENCO.

8610-0533 Rev 1.0.0 Sht 4 -Power.SchDoc

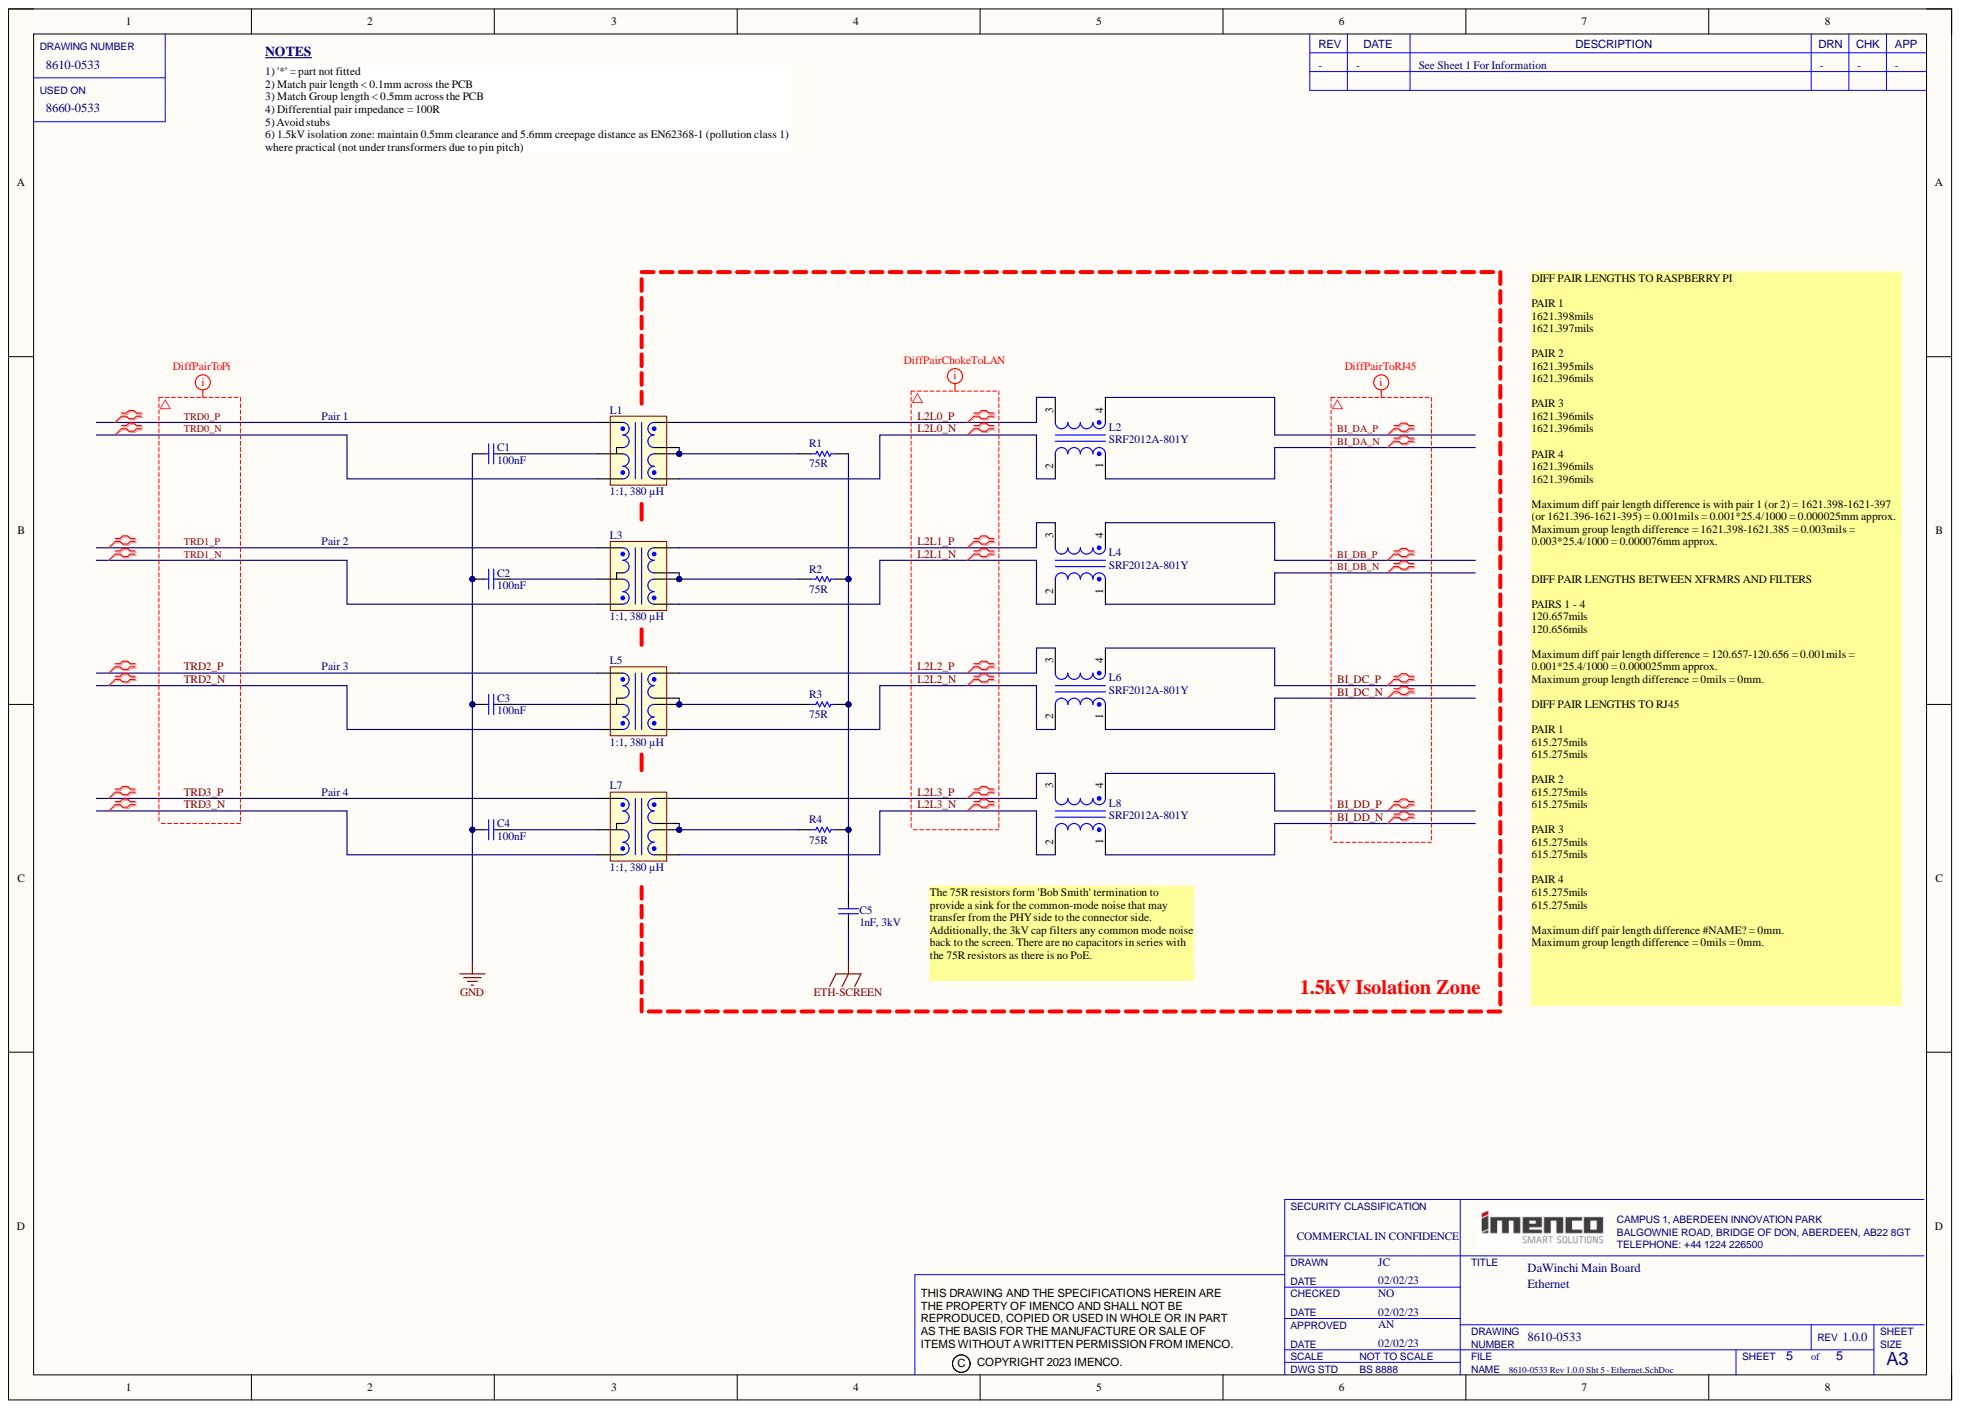
[picture p39: page 5]

There are no capaci

CAMPUS 1, ABERDEEN INNOV
BALGOWNIE ROAD, BRIDGE OF DON, ABERDEEN, AB22 8GT
TELEPHONE:

NOT TO SCALE JC
