pyrat/sv/sv-docs/dawinchi/drum-115669.pdf

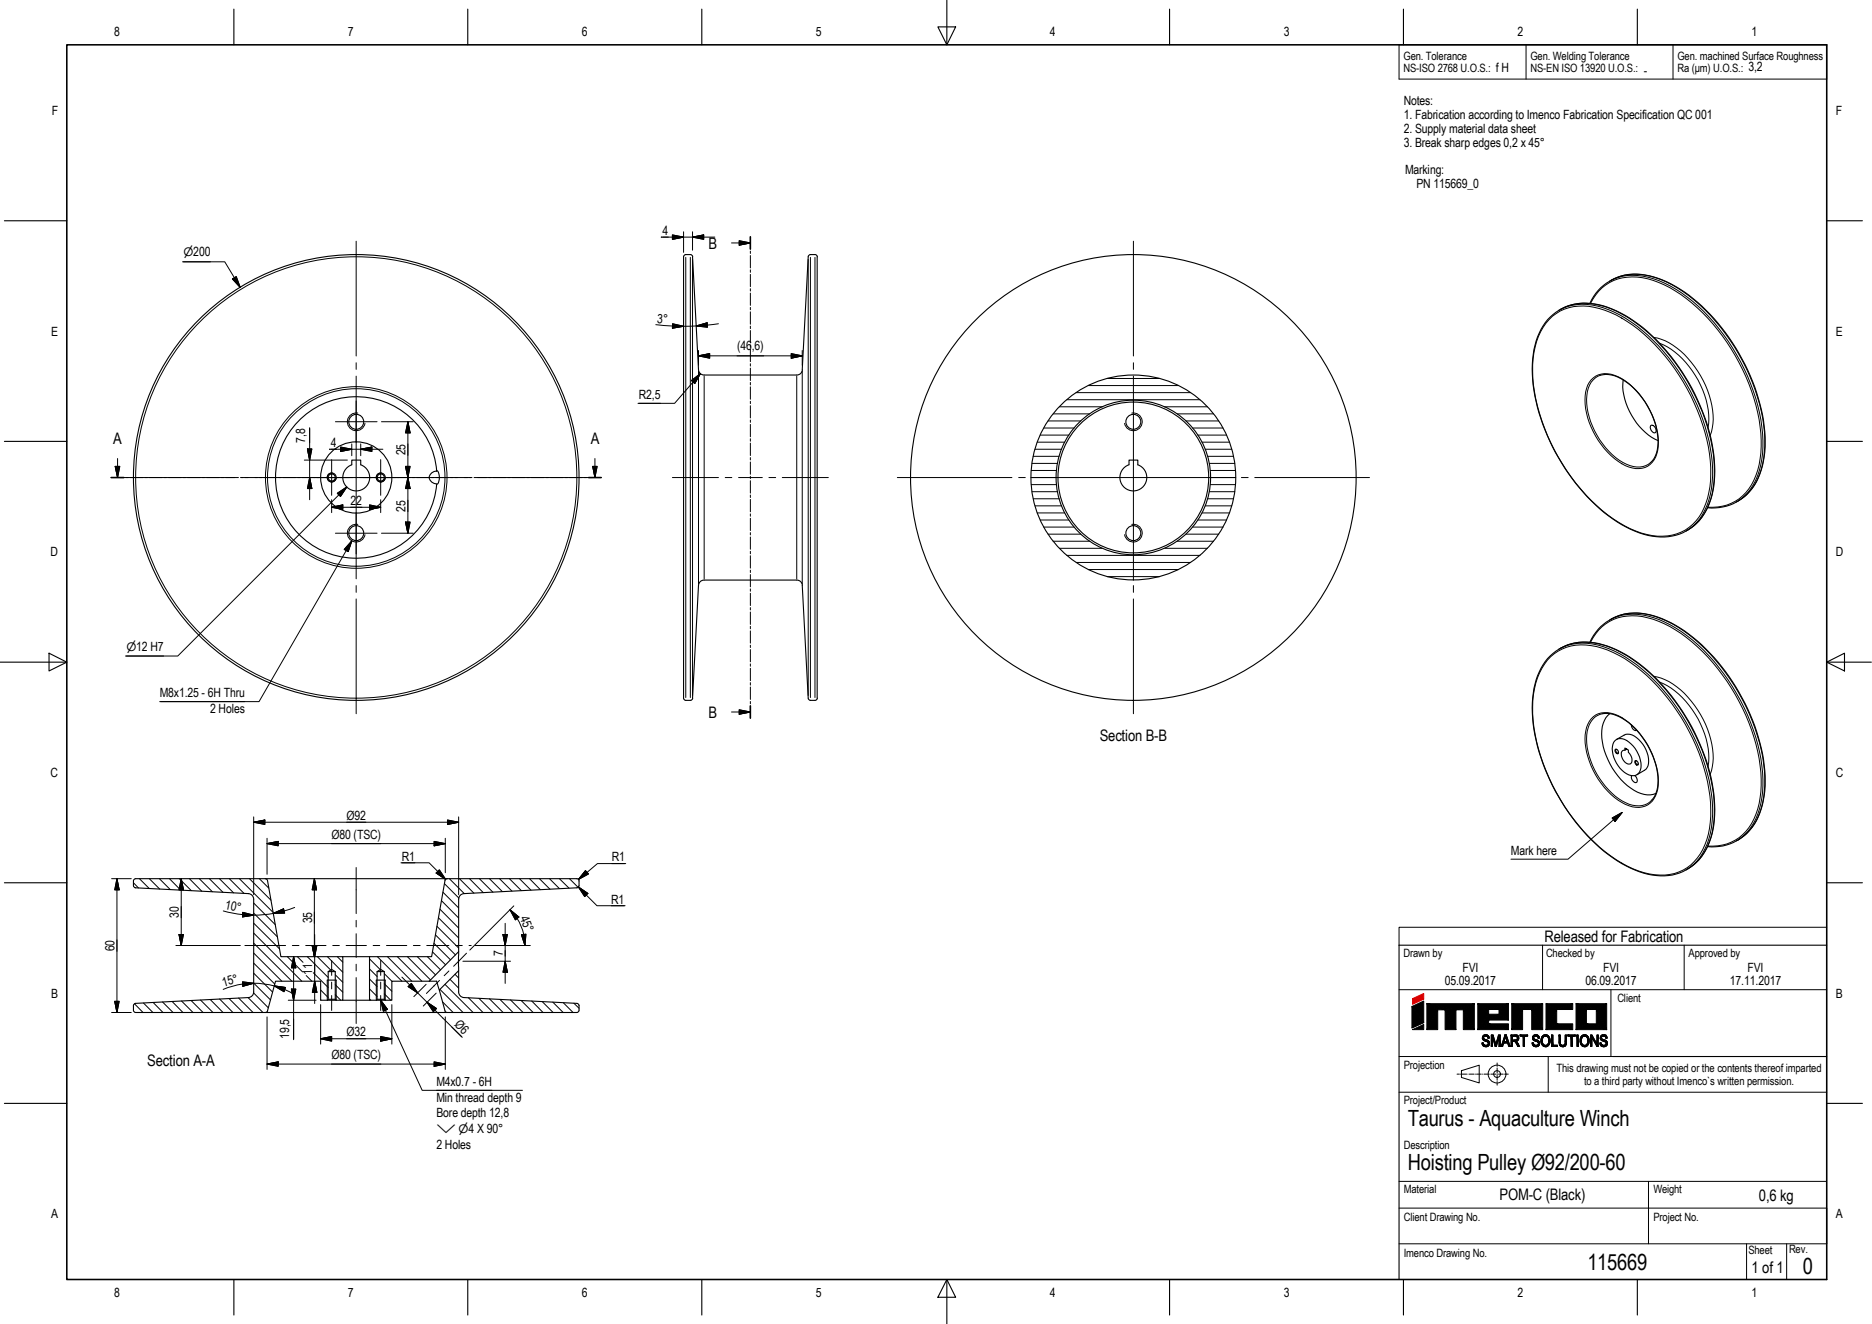
[picture p40: page 1]
Section A-A; Section B-B; Gen. Tolerance NS-ISO 2768 U.O.S.:; Hoisting Pulley Ø92/200-60; Ø80 (TSC); M4x0.7 - 6H Min thread depth 9; 2 Holes; Bore depth 12,8; Mark here; M8x1.25 - 6H Thru 2 Holes

Gen. Welding Tolerance

Gen. machined Surface Roughness

NS-EN ISO 13920 U.O.S.:

Notes:
1. Fabrication according to Imenco Fabrication Specification QC 001
2. Supply material data sheet
3. Break sharp edges 0,2 x 45°

Released for Fabrication

Drawn by FVI 05.09.2017 | Checked by FVI 06.09.2017 | Approved by FVI 17.11.2017

Client

Projection | This drawing must not be copied or the contents thereof imparted to a third party without Imenco`s written permission.

Project/Product
Taurus - Aquaculture Winch

Material POM-C (Black) | Weight 0,6 kg

Client Drawing No. | Project No.

Imenco Drawing No.
