pyrat/sv/(commit log)

2026-10-13 adding wiring and more breakdowns
2026-10-26 adding prototype drums
2026-10-28 adding docs for brake configuration
2026-10-30 adding some wiring diags
2026-11-02 adding some wiring
2026-11-04 adding printable DIN mount for jetson.
2026-11-05 adding jetson firmware upgrade to docs
2026-11-07 mods to the din mounting
